tobiwan88/desk_notifier/hardware/mechanics/display_dummy.stl

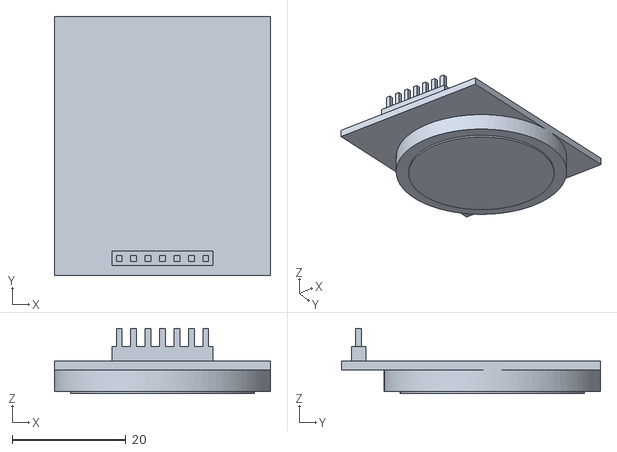
[picture p3: CAD file, 2026-10-22]
hardware/mechanics/display_dummy.stl
38.0 x 45.5 x 11.5
