tobiwan88/desk_notifier/hardware/notifier-v1/notifier-v1.step

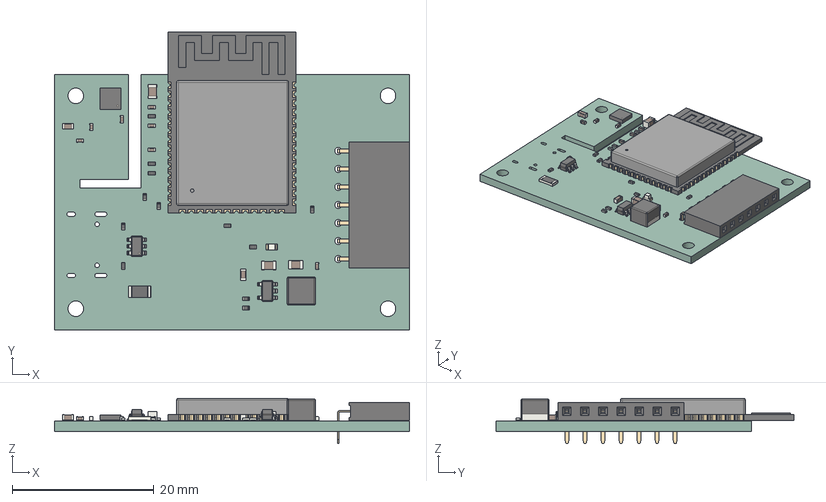
[picture p4: CAD file, 2026-10-22]
hardware/notifier-v1/notifier-v1.step
50.0 x 42.0 x 6.40 mm
Bosch_LGA_8_3x3mm_P08mm_ClockwisePinNumbering
C_0402_1005Metric x 7
R_0402_1005Metric x 12
C_0603_1608Metric x 2
C_0805_2012Metric x 3
SOT-23-6
PinSocket_1x07_P2.54mm_Horizontal
LED_0603_1608Metric
ESP32-S3-WROOM-1
SOT-23-5
L_Cenker_CKCS4030
Fuse_1206_3216Metric
notifier-v1-unsaved-export-hy6Hpy_PCB
