tobiwan88/desk_notifier/hardware/mechanics/coupon_m1.stl

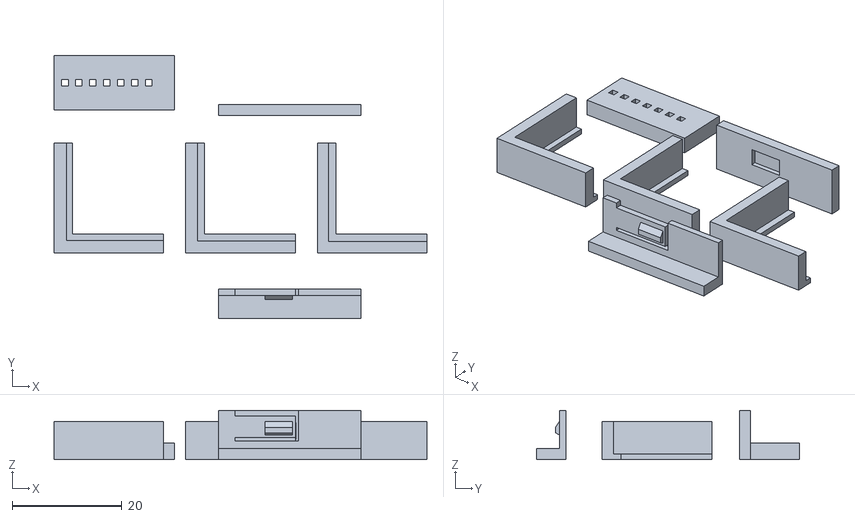
[picture p5: CAD file, 2026-10-22]
hardware/mechanics/coupon_m1.stl
68.0 x 48.0 x 9.00
