tobiwan88/desk_notifier/hardware/mechanics/plate_shell_cover.3mf

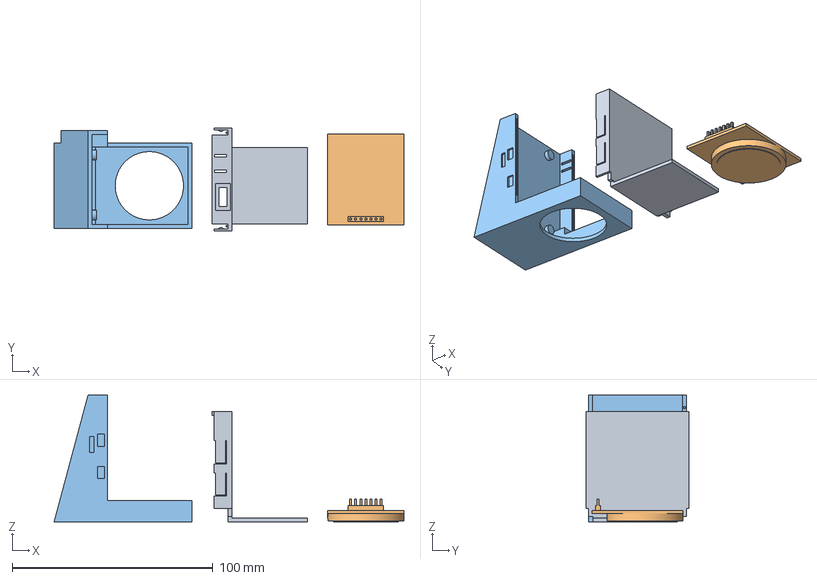
[picture p6: CAD file, 2026-10-22]
hardware/mechanics/plate_shell_cover.3mf
174.4 x 51.5 x 63.3 mm
cover
display_dummy
