tobiwan88/desk_notifier/hardware/mechanics/cover.stl

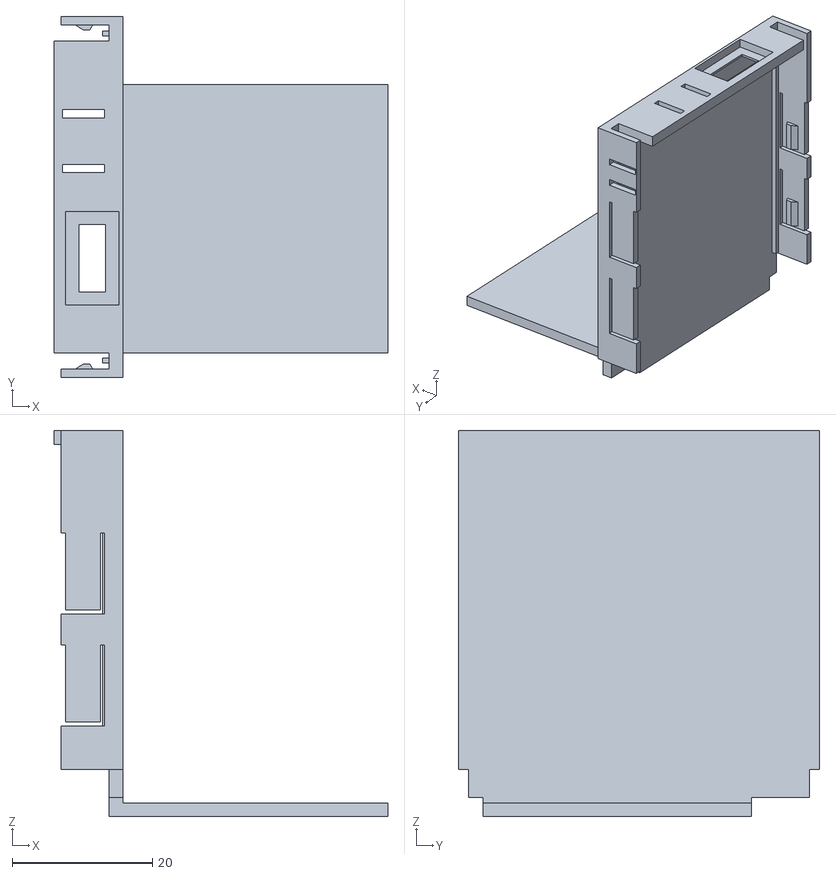
[picture p7: CAD file, 2026-10-22]
hardware/mechanics/cover.stl
47.6 x 51.5 x 55.1
