tobiwan88/desk_notifier/hardware/mechanics/shell.stl

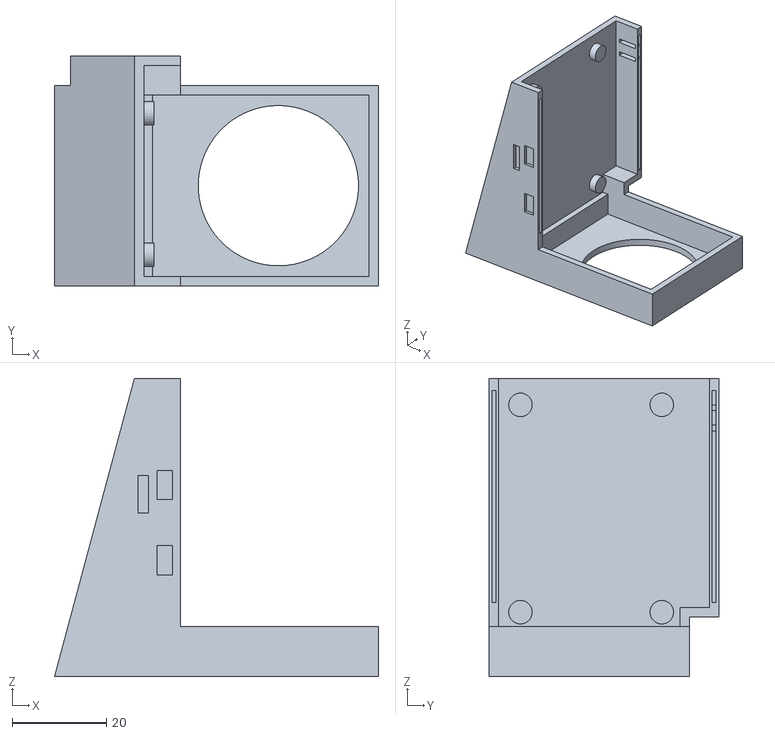
[picture p8: CAD file, 2026-10-22]
hardware/mechanics/shell.stl
68.8 x 48.7 x 63.3
