tobiwan88/desk_notifier/(list of files, cad)

Other CAD files:
hardware/mechanics/desk_notifier_housing.f3d
hardware/mechanics/plate_shell_cover.stl
