tobiwan88/desk_notifier/hardware/notifier-v1/notifier-v1.kicad_pcb

## KiCad design hardware/notifier-v1/notifier-v1.kicad_pcb (2026-10-22)

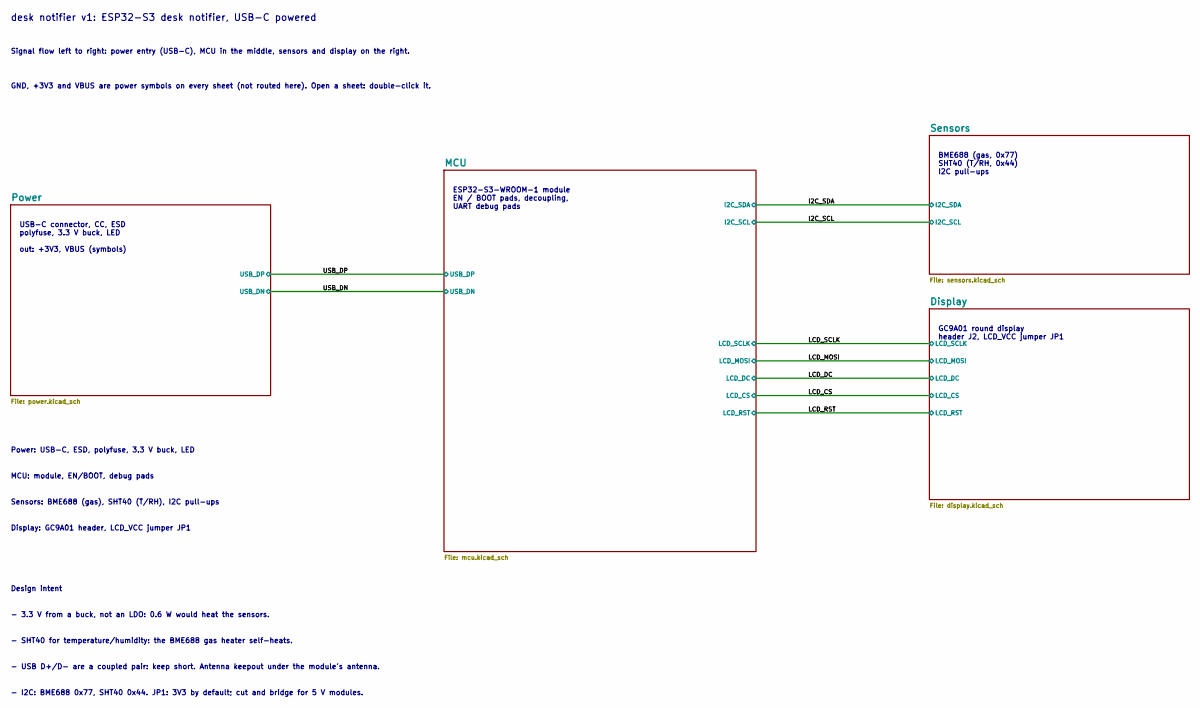
[picture p9: schematic notifier-v1.kicad_sch, desk notifier v1]

Notes on the sheet:
USB-C connector, CC, ESD polyfuse, 3.3 V buck, LED out: +3V3, VBUS (symbols)
ESP32-S3-WROOM-1 module EN / BOOT pads, decoupling, UART debug pads
Design intent
- 3.3 V from a buck, not an LDO: 0.6 W would heat the sensors.
MCU: module, EN/BOOT, debug pads
Power: USB-C, ESD, polyfuse, 3.3 V buck, LED
Signal flow left to right: power entry (USB-C), MCU in the middle, sensors and display on the right.
- USB D+/D- are a coupled pair: keep short. Antenna keepout under the module's antenna.
desk notifier v1: ESP32-S3 desk notifier, USB-C powered
GND, +3V3 and VBUS are power symbols on every sheet (not routed here). Open a sheet: double-click it.
- I2C: BME688 0x77, SHT40 0x44. JP1: 3V3 by default; cut and bridge for 5 V modules.
GC9A01 round display header J2, LCD_VCC jumper JP1
Display: GC9A01 header, LCD_VCC jumper JP1
BME688 (gas, 0x77) SHT40 (T/RH, 0x44) I2C pull-ups
Sensors: BME688 (gas), SHT40 (T/RH), I2C pull-ups
- SHT40 for temperature/humidity: the BME688 gas heater self-heats.

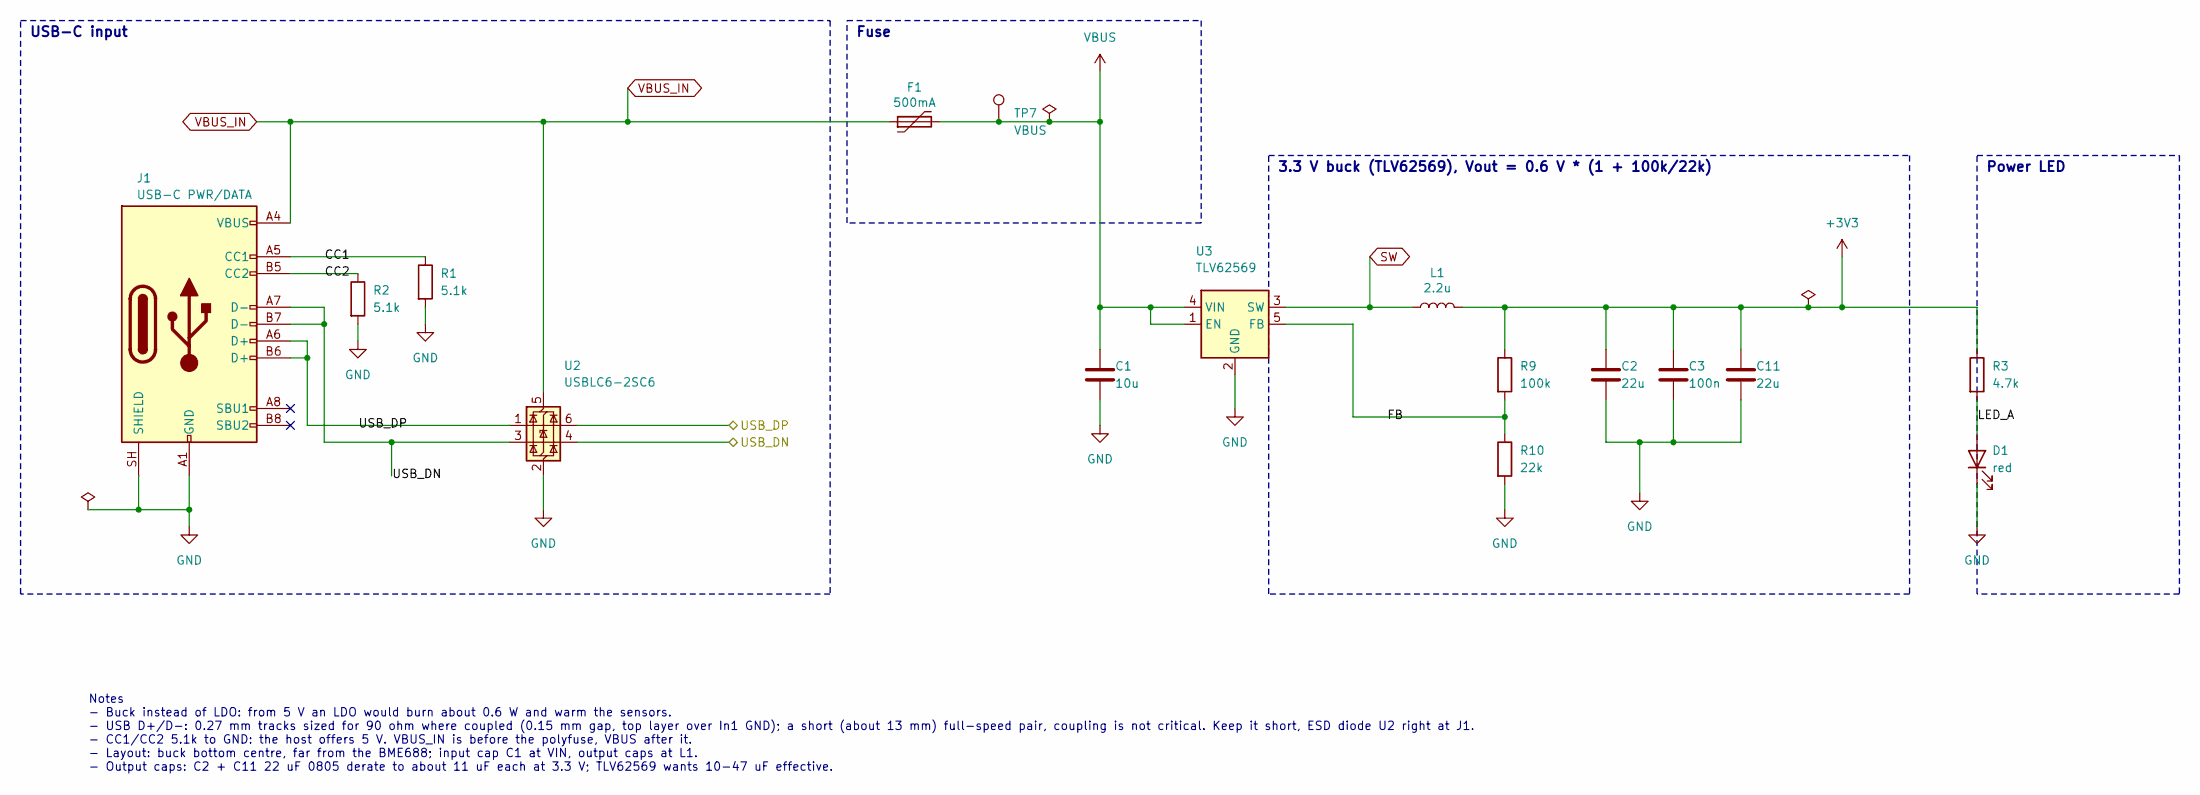
[picture p10: schematic power.kicad_sch, desk notifier v1]

Parts:
C1: 10u; C_0603_1608Metric; LCSC C19702
C2, C11: 22u; C_0805_2012Metric; LCSC C45783
C3: 100n; C_0402_1005Metric; LCSC C1525
D1: red; LED_0603_1608Metric; LCSC C2286
F1: 500mA; Fuse_1206_3216Metric; LCSC C70077
J1: USB-C PWR/DATA; USB_C_Receptacle_HRO_TYPE-C-31-M-12; LCSC C165948
L1: 2.2u; L_Cenker_CKCS4030; LCSC C354584
R1, R2: 5.1k; R_0402_1005Metric; LCSC C25905
R3: 4.7k; R_0402_1005Metric; LCSC C25900
R9: 100k; R_0402_1005Metric; LCSC C25741
R10: 22k; R_0402_1005Metric; LCSC C25768
TP7: VBUS; TestPoint_Pad_D1.0mm
U2: USBLC6-2SC6; SOT-23-6; LCSC C7519
U3: TLV62569; SOT-23-5; LCSC C141836

Connections:
+3V3: C2.1, C3.1, C11.1, L1.2, R3.1, R9.1; also elsewhere on the board
/Power/CC1: J1.A5 (CC1), R1.1
/Power/CC2: J1.B5 (CC2), R2.1
/Power/FB: R9.2, R10.1, U3.5 (FB)
/Power/LED_A: D1.2 (A), R3.2
/USB_DN: J1.A7 (D-), J1.B7 (D-), U2.3 (I/O2), U2.4 (I/O2); also elsewhere on the board
/USB_DP: J1.A6 (D+), J1.B6 (D+), U2.1 (I/O1), U2.6 (I/O1); also elsewhere on the board
GND: C1.2, C2.2, C3.2, C11.2, D1.1 (K), J1.A1 (GND), J1.A12 (GND), J1.B1 (GND), J1.B12 (GND), J1.SH (SHIELD), R1.2, R2.2, R10.2, U2.2 (GND), U3.2 (GND); also elsewhere on the board
SW: L1.1, U3.3 (SW)
VBUS: C1.1, F1.2, TP7.1, U3.1 (EN), U3.4 (VIN); also elsewhere on the board
VBUS_IN: F1.1, J1.A4 (VBUS), J1.A9 (VBUS), J1.B4 (VBUS), J1.B9 (VBUS), U2.5 (VBUS)

Notes on the sheet:
3.3 V buck (TLV62569), Vout = 0.6 V * (1 + 100k/22k)
USB-C input
Notes - Buck instead of LDO: from 5 V an LDO would burn about 0.6 W and warm the sensors. - USB D+/D-: 0.27 mm tracks sized for 90 ohm where coupled (0.15 mm gap, top layer over In1 GND); a short (about 13 mm) full-speed pair, coupling is not critical. Keep it short, ESD diode U2 right at J1. - CC1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
Power LED
Fuse

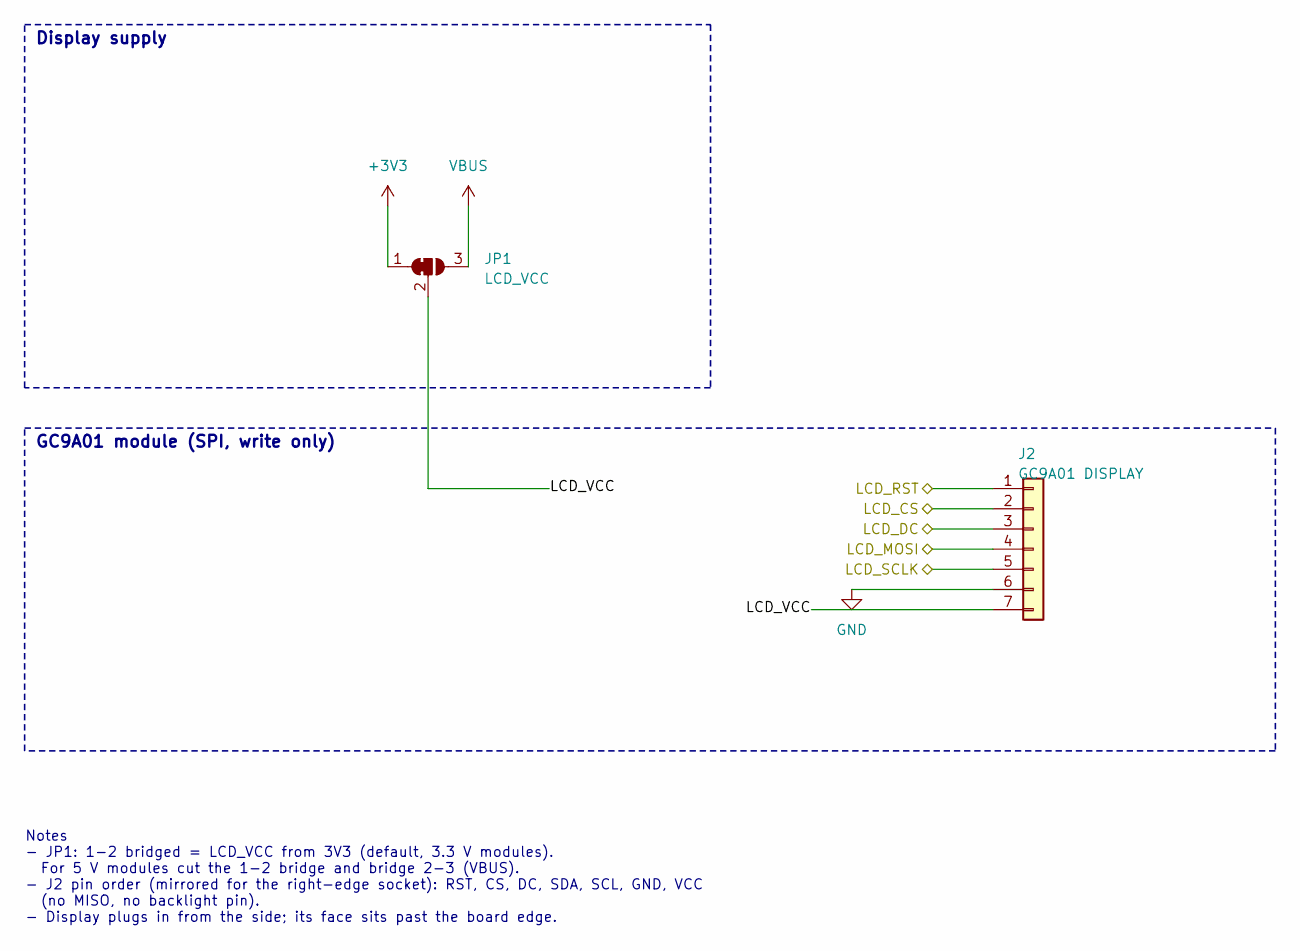
[picture p11: schematic display.kicad_sch, desk notifier v1]

Parts:
J2: GC9A01 DISPLAY; PinSocket_1x07_P2.54mm_Horizontal; LCSC C22436148
JP1: LCD_VCC; SolderJumper-3_P1.3mm_Bridged12_RoundedPad1.0x1.5mm

Connections:
+3V3: JP1.1 (A); also elsewhere on the board
/Display/LCD_VCC: J2.7, JP1.2 (C)
/LCD_CS: J2.2; also elsewhere on the board
/LCD_DC: J2.3; also elsewhere on the board
/LCD_MOSI: J2.4; also elsewhere on the board
/LCD_RST: J2.1; also elsewhere on the board
/LCD_SCLK: J2.5; also elsewhere on the board
GND: J2.6; also elsewhere on the board
VBUS: JP1.3 (B); also elsewhere on the board

Notes on the sheet:
Display supply
GC9A01 module (SPI, write only)
Notes - JP1: 1-2 bridged = LCD_VCC from 3V3 (default, 3.3 V modules). For 5 V modules cut the 1-2 bridge and bridge 2-3 (VBUS). - J2 pin order (mirrored for the right-edge socket): RST, CS, DC, SDA, SCL, GND, VCC (no MISO, no backlight pin). - Display plugs in from the side; its face sits past the 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

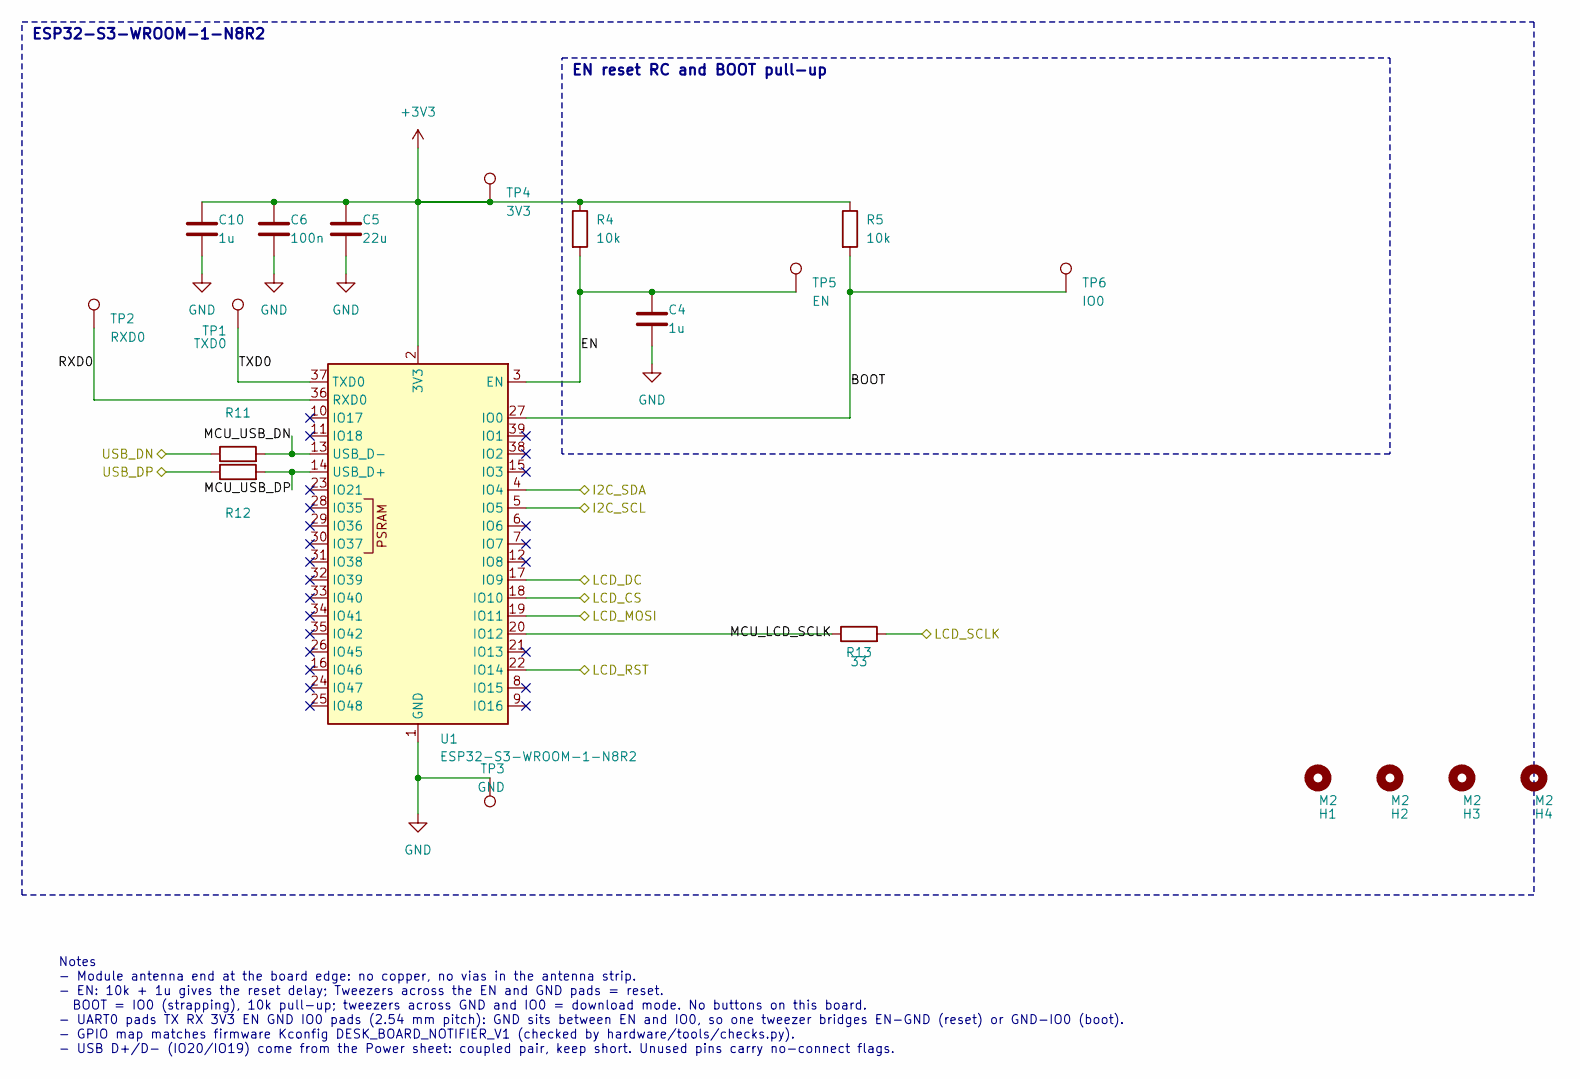
[picture p12: schematic mcu.kicad_sch, desk notifier v1]

Parts:
C4, C10: 1u; C_0402_1005Metric; LCSC C52923
C5: 22u; C_0805_2012Metric; LCSC C45783
C6: 100n; C_0402_1005Metric; LCSC C1525
H1, H2, H3, H4: M2; MountingHole_2.2mm_M2
R4, R5: 10k; R_0402_1005Metric; LCSC C25744
R11, R12: 22; R_0402_1005Metric; LCSC C25092
R13: 33; R_0402_1005Metric; LCSC C25105
TP1: TXD0; TestPoint_Pad_D1.5mm
TP2: RXD0; TestPoint_Pad_D1.5mm
TP3: GND; TestPoint_Pad_D1.5mm
TP4: 3V3; TestPoint_Pad_D1.5mm
TP5: EN; TestPoint_Pad_D1.5mm
TP6: IO0; TestPoint_Pad_D1.5mm
U1: ESP32-S3-WROOM-1-N8R2; ESP32-S3-WROOM-1; LCSC C2913204

Connections:
+3V3: C5.1, C6.1, C10.1, R4.1, R5.1, TP4.1, U1.2 (3V3); also elsewhere on the board
/I2C_SCL: U1.5 (IO5); also elsewhere on the board
/I2C_SDA: U1.4 (IO4); also elsewhere on the board
/LCD_CS: U1.18 (IO10); also elsewhere on the board
/LCD_DC: U1.17 (IO9); also elsewhere on the board
/LCD_MOSI: U1.19 (IO11); also elsewhere on the board
/LCD_RST: U1.22 (IO14); also elsewhere on the board
/LCD_SCLK: R13.2; also elsewhere on the board
/MCU/BOOT: R5.2, TP6.1, U1.27 (IO0)
/MCU/EN: C4.1, R4.2, TP5.1, U1.3 (EN)
/MCU/MCU_LCD_SCLK: R13.1, U1.20 (IO12)
/MCU/MCU_USB_DN: R11.2, U1.13 (USB_D-)
/MCU/MCU_USB_DP: R12.2, U1.14 (USB_D+)
/MCU/RXD0: TP2.1, U1.36 (RXD0)
/MCU/TXD0: TP1.1, U1.37 (TXD0)
/USB_DN: R11.1; also elsewhere on the board
/USB_DP: R12.1; also elsewhere on the board
GND: C4.2, C5.2, C6.2, C10.2, TP3.1, U1.1 (GND), U1.40 (GND), U1.41 (GND); also elsewhere on the board

Notes on the sheet:
ESP32-S3-WROOM-1-N8R2
EN reset RC and BOOT pull-up
Notes - Module antenna end at the board edge: no copper, no vias in the antenna strip. - EN: 10k + 1u gives the reset delay; Tweezers across the EN and GND pads = reset. BOOT = IO0 (strapping), 10k pull-up; tweezers across GND and IO0 = download mode. No buttons on this board. - UART0 pads TX RX 3V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

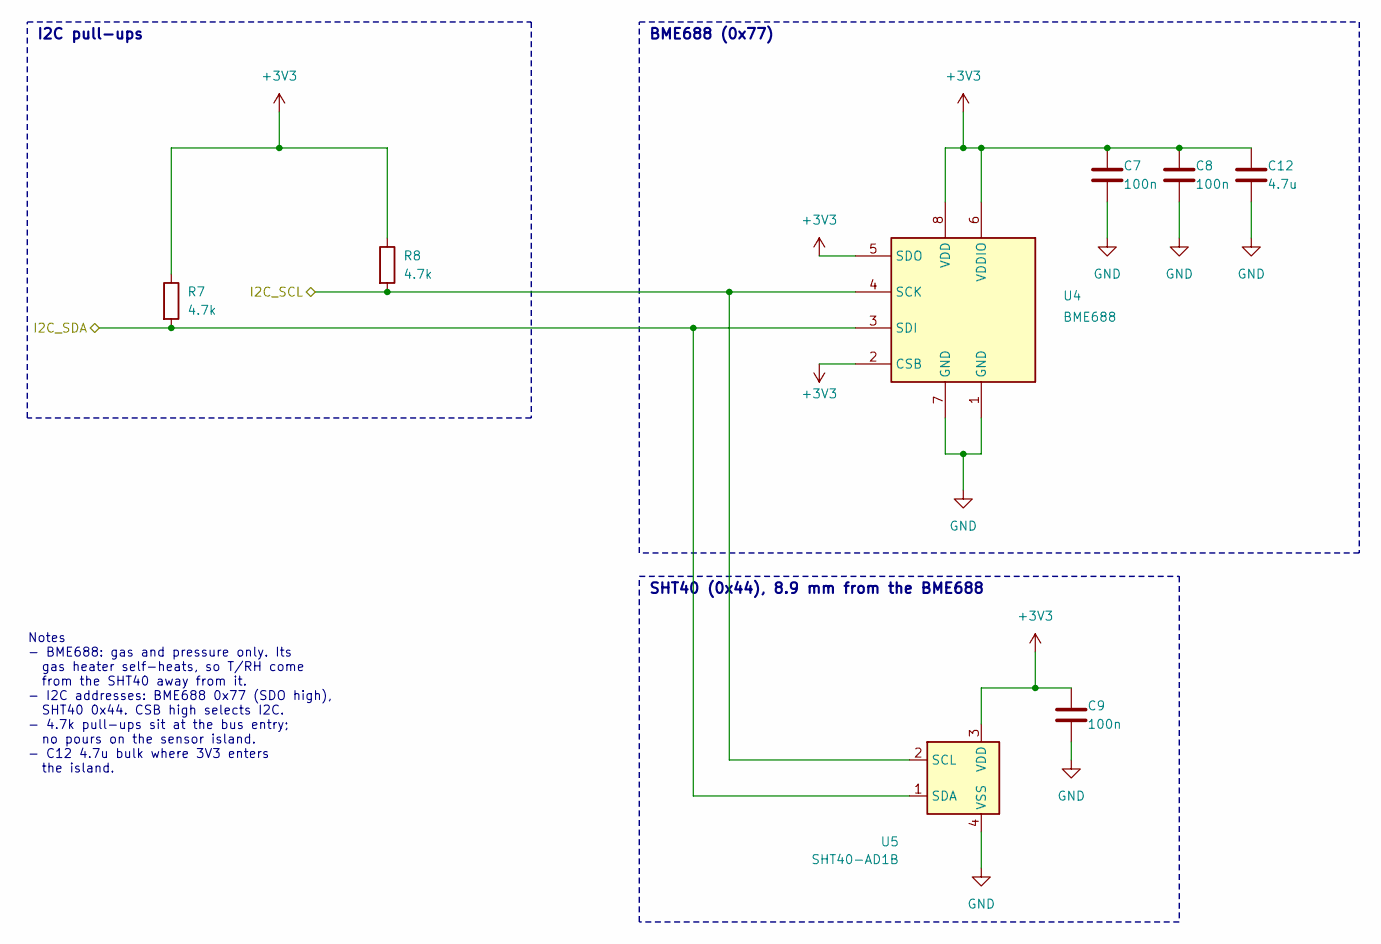
[picture p13: schematic sensors.kicad_sch, desk notifier v1]

Parts:
C7, C8, C9: 100n; C_0402_1005Metric; LCSC C1525
C12: 4.7u; C_0603_1608Metric; LCSC C19666
R7, R8: 4.7k; R_0402_1005Metric; LCSC C25900
U4: BME688; Bosch_LGA-8_3x3mm_P0.8mm_ClockwisePinNumbering; LCSC C3664478
U5: SHT40-AD1B; Sensirion_DFN-4_1.5x1.5mm_P0.8mm_SHT4x_NoCentralPad; LCSC C2909890

Connections:
+3V3: C7.1, C8.1, C9.1, C12.1, R7.1, R8.1, U4.2 (CSB), U4.5 (SDO), U4.6 (VDDIO), U4.8 (VDD), U5.3 (VDD); also elsewhere on the board
/I2C_SCL: R8.2, U4.4 (SCK), U5.2 (SCL); also elsewhere on the board
/I2C_SDA: R7.2, U4.3 (SDI), U5.1 (SDA); also elsewhere on the board
GND: C7.2, C8.2, C9.2, C12.2, U4.1 (GND), U4.7 (GND), U5.4 (VSS); also elsewhere on the board

Notes on the sheet:
SHT40 (0x44), 8.9 mm from the BME688
Notes - BME688: gas and pressure only. Its gas heater self-heats, so T/RH come from the SHT40 away from it. - I2C addresses: BME688 0x77 (SDO high), SHT40 0x44. CSB high selects I2C. - 4.7k pull-ups sit at the bus entry; no pours on the sensor island. - C12 4.7u bulk where 3V3 enters the island.
BME688 (0x77)
I2C pull-ups

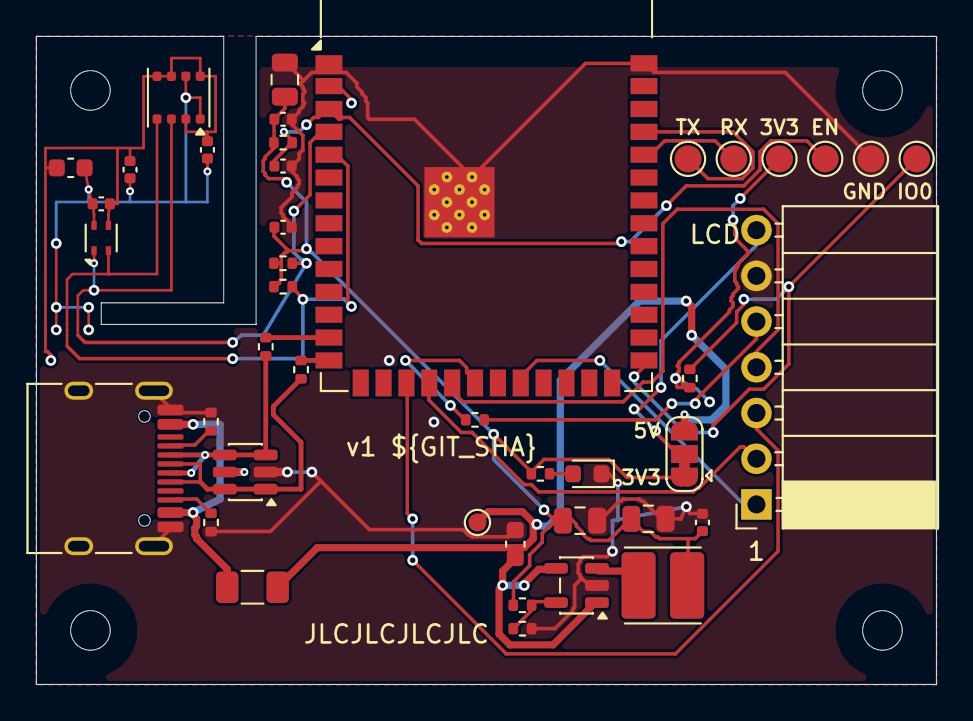
[picture p14: board notifier-v1.kicad_pcb from above]

Board: 4 copper layers, 50.0 x 36.0 mm, 46 parts (0 on the bottom side), 26 nets.
