tobiwan88/desk_notifier/hardware/gen/notifier_v1.py

"""notifier-v1 schematic: ESP32-S3-WROOM-1, USB-C power/data, TLV62569 buck, BME688, 7-pin GC9A01 header, SHT40.

PARTS and NETS are the source of truth; the checks (tools/checks.py) import them.
Run: uv run --package desk-hardware python hardware/gen/notifier_v1.py [out_dir]
"""

import sys
from pathlib import Path

sys.path.insert(0, str(Path(__file__).resolve().parent))
from schkit import check_nets  # noqa: E402

R0402, C0402 = "Resistor_SMD:R_0402_1005Metric", "Capacitor_SMD:C_0402_1005Metric"
C0603, C0805 = "Capacitor_SMD:C_0603_1608Metric", "Capacitor_SMD:C_0805_2012Metric"

# ref: (symbol, value, footprint, LCSC, schematic sheet, rotation on the PCB-era sketch (unused by the drawing))
PARTS = {
    # USB-C input and ESD
    "J1": ("Connector:USB_C_Receptacle_USB2.0_16P", "USB-C PWR/DATA", "Connector_USB:USB_C_Receptacle_HRO_TYPE-C-31-M-12", "C165948", "Power", 0),
    "R1": ("Device:R", "5.1k", R0402, "C25905", "Power", 0),
    "R2": ("Device:R", "5.1k", R0402, "C25905", "Power", 0),
    "U2": ("Power_Protection:USBLC6-2SC6", "USBLC6-2SC6", "Package_TO_SOT_SMD:SOT-23-6", "C7519", "Power", 0),
    # VBUS polyfuse, 3.3 V buck (a linear regulator would burn ~0.6 W and warm the BME688)
    "F1": ("Device:Polyfuse", "500mA", "Fuse:Fuse_1206_3216Metric", "C70077", "Power", 90),
    "U3": ("Regulator_Switching:TLV62569DBV", "TLV62569", "Package_TO_SOT_SMD:SOT-23-5", "C141836", "Power", 0),
    "L1": ("Device:L", "2.2u", "Inductor_SMD:L_Cenker_CKCS4030", "C354584", "Power", 90),
    "R9": ("Device:R", "100k", R0402, "C25741", "Power", 0),   # Vout = 0.6 V * (1 + R9/R10) = 3.33 V
    "R10": ("Device:R", "22k", R0402, "C25768", "Power", 0),
    "C1": ("Device:C", "10u", C0603, "C19702", "Power", 0),
    # Output cap: TI TLV62569 datasheet (https://www.ti.com/lit/ds/symlink/tlv62569.pdf) sec 8.2.2.5: 10-47 uF effective.
    # One 22 uF 0805 derates to about 11 uF at 3.3 V DC bias, so C11 is a second one for margin.
    "C2": ("Device:C", "22u", C0805, "C45783", "Power", 0),
    "C11": ("Device:C", "22u", C0805, "C45783", "Power", 0),
    "C3": ("Device:C", "100n", C0402, "C1525", "Power", 0),
    "R3": ("Device:R", "4.7k", R0402, "C25900", "Power", 0),
    "D1": ("Device:LED", "red", "LED_SMD:LED_0603_1608Metric", "C2286", "Power", 90),
    # ESP32-S3 module, reset RC, boot pull-up (no buttons on this board: debug pads)
    "U1": ("RF_Module:ESP32-S3-WROOM-1", "ESP32-S3-WROOM-1-N8R2", "RF_Module:ESP32-S3-WROOM-1", "C2913204", "MCU", 0),
    # 3V3 decoupling per Espressif ESP32-S3 Hardware Design Guidelines, schematic checklist "Power Supply"
    # (https://docs.espressif.com/projects/esp-hardware-design-guidelines/en/latest/esp32s3/schematic-checklist.html):
    # 10 uF + 1 uF + 0.1 uF at the module 3V3 pin. C5 22 uF 0805 (>=10 uF after derating), C10 1 uF, C6 100 nF.
    "C5": ("Device:C", "22u", C0805, "C45783", "MCU", 0),
    "C6": ("Device:C", "100n", C0402, "C1525", "MCU", 0),
    "C10": ("Device:C", "1u", C0402, "C52923", "MCU", 0),
    # USB D+/D- series resistors, 22 ohm, close to the module pins: Espressif schematic checklist, section "USB"
    # (same URL): "series resistors of 22 to 33 ohm" on D+/D-. UNI-ROYAL 0402WGF220JTCE, 1 %, Basic.
    "R11": ("Device:R", "22", R0402, "C25092", "MCU", 0),   # USB_DN -> MCU_USB_DN (module pin 13)
    "R12": ("Device:R", "22", R0402, "C25092", "MCU", 0),   # USB_DP -> MCU_USB_DP (module pin 14)
    "R13": ("Device:R", "33", R0402, "C25105", "MCU", 0),   # LCD SCLK series termination at module pin 20
    "R4": ("Device:R", "10k", R0402, "C25744", "MCU", 0),
    "C4": ("Device:C", "1u", C0402, "C52923", "MCU", 0),
    "R5": ("Device:R", "10k", R0402, "C25744", "MCU", 0),
    # BME688 (BME680 symbol: same LGA-8 pinout)
    "U4": ("Sensor:BME680", "BME688", "Package_LGA:Bosch_LGA-8_3x3mm_P0.8mm_ClockwisePinNumbering", "C3664478", "Sensors", 0),
    "C7": ("Device:C", "100n", C0402, "C1525", "Sensors", 0),
    "C8": ("Device:C", "100n", C0402, "C1525", "Sensors", 0),
    # SHT40 (0x44): temperature/humidity away from the BME688's gas heater
    "U5": ("Sensor_Humidity:SHT4x", "SHT40-AD1B", "Sensor_Humidity:Sensirion_DFN-4_1.5x1.5mm_P0.8mm_SHT4x_NoCentralPad", "C2909890", "Sensors", 0),
    "C9": ("Device:C", "100n", C0402, "C1525", "Sensors", 0),
    "C12": ("Device:C", "4.7u", C0603, "C19666", "Sensors", 0),   # bulk where 3V3 enters the island (gas heater pulses)
    "R7": ("Device:R", "4.7k", R0402, "C25900", "Sensors", 0),
    "R8": ("Device:R", "4.7k", R0402, "C25900", "Sensors", 0),
    # GC9A01 display header and its supply selector (default 3V3, cut and bridge 2-3 for 5 V)
    "J2": ("Connector_Generic:Conn_01x07", "GC9A01 DISPLAY", "Connector_PinSocket_2.54mm:PinSocket_1x07_P2.54mm_Horizontal", "C22436148", "Display", 0),
    "JP1": ("Jumper:SolderJumper_3_Bridged12", "LCD_VCC", "Jumper:SolderJumper-3_P1.3mm_Bridged12_RoundedPad1.0x1.5mm", None, "Display", 0),
    # debug UART pads, mounting holes
    "TP1": ("Connector:TestPoint", "TXD0", "TestPoint:TestPoint_Pad_D1.5mm", None, "MCU", 0),
    "TP2": ("Connector:TestPoint", "RXD0", "TestPoint:TestPoint_Pad_D1.5mm", None, "MCU", 0),
    "TP3": ("Connector:TestPoint", "GND", "TestPoint:TestPoint_Pad_D1.5mm", None, "MCU", 0),
    "TP4": ("Connector:TestPoint", "3V3", "TestPoint:TestPoint_Pad_D1.5mm", None, "MCU", 0),
    "TP5": ("Connector:TestPoint", "EN", "TestPoint:TestPoint_Pad_D1.5mm", None, "MCU", 0),
    "TP6": ("Connector:TestPoint", "IO0", "TestPoint:TestPoint_Pad_D1.5mm", None, "MCU", 0),
    "TP7": ("Connector:TestPoint", "VBUS", "TestPoint:TestPoint_Pad_D1.0mm", None, "Power", 0),
    "H1": ("Mechanical:MountingHole", "M2", "MountingHole:MountingHole_2.2mm_M2", None, "MCU", 0),
    "H2": ("Mechanical:MountingHole", "M2", "MountingHole:MountingHole_2.2mm_M2", None, "MCU", 0),
    "H3": ("Mechanical:MountingHole", "M2", "MountingHole:MountingHole_2.2mm_M2", None, "MCU", 0),
    "H4": ("Mechanical:MountingHole", "M2", "MountingHole:MountingHole_2.2mm_M2", None, "MCU", 0),
    "#FLG01": ("power:PWR_FLAG", "PWR_FLAG", None, None, "Power", 0),
    "#FLG02": ("power:PWR_FLAG", "PWR_FLAG", None, None, "Power", 0),
    "#FLG03": ("power:PWR_FLAG", "PWR_FLAG", None, None, "Power", 0),
}

# module pin -> GPIO, for the pin map check against firmware Kconfig
U1_GPIO = {"4": 4, "5": 5, "17": 9, "18": 10, "19": 11, "20": 12, "22": 14, "27": 0, "13": 19, "14": 20, "37": 43, "36": 44}
U1_UNUSED = ["6", "7", "8", "9", "10", "11", "12", "15", "16", "21", "23", "24", "25", "26", "28", "29", "30", "31", "32", "33", "34", "35", "38", "39"]

NETS = {
    "VBUS_IN": [("J1", "A4"), ("J1", "A9"), ("J1", "B4"), ("J1", "B9"), ("U2", "5"), ("F1", "1")],
    "VBUS": [("F1", "2"), ("U3", "4"), ("U3", "1"), ("C1", "1"), ("JP1", "3"), ("TP7", "1"), ("#FLG01", "1")],
    "SW": [("U3", "3"), ("L1", "1")],
    "FB": [("U3", "5"), ("R9", "2"), ("R10", "1")],
    "GND": [("J1", "A1"), ("J1", "A12"), ("J1", "B1"), ("J1", "B12"), ("J1", "SH"), ("R1", "2"), ("R2", "2"), ("U2", "2"),
            ("U3", "2"), ("R10", "2"), ("C1", "2"), ("C2", "2"), ("C3", "2"), ("C11", "2"), ("D1", "1"), ("U1", "1"), ("U1", "40"), ("U1", "41"),
            ("C5", "2"), ("C6", "2"), ("C10", "2"), ("C4", "2"), ("U4", "1"), ("U4", "7"),
            ("C7", "2"), ("C8", "2"), ("U5", "4"), ("C9", "2"), ("C12", "2"), ("J2", "6"), ("TP3", "1"), ("#FLG02", "1")],
    "+3V3": [("L1", "2"), ("R9", "1"), ("TP4", "1"), ("#FLG03", "1"), ("C2", "1"), ("C3", "1"), ("C11", "1"), ("C10", "1"), ("R3", "1"), ("U1", "2"), ("C5", "1"), ("C6", "1"), ("R4", "1"),
             ("R5", "1"), ("U4", "8"), ("U4", "6"), ("U4", "2"), ("U4", "5"), ("C7", "1"), ("C8", "1"), ("U5", "3"), ("C9", "1"), ("C12", "1"),
             ("R7", "1"), ("R8", "1"), ("JP1", "1")],
    "CC1": [("J1", "A5"), ("R1", "1")],
    "CC2": [("J1", "B5"), ("R2", "1")],
    "USB_DP": [("J1", "A6"), ("J1", "B6"), ("U2", "1"), ("U2", "6"), ("R12", "1")],
    "MCU_USB_DP": [("R12", "2"), ("U1", "14")],
    "USB_DN": [("J1", "A7"), ("J1", "B7"), ("U2", "3"), ("U2", "4"), ("R11", "1")],
    "MCU_USB_DN": [("R11", "2"), ("U1", "13")],
    "LED_A": [("R3", "2"), ("D1", "2")],
    "EN": [("U1", "3"), ("R4", "2"), ("C4", "1"), ("TP5", "1")],
    "BOOT": [("U1", "27"), ("R5", "2"), ("TP6", "1")],
    "I2C_SDA": [("U1", "4"), ("U4", "3"), ("U5", "1"), ("R7", "2")],
    "I2C_SCL": [("U1", "5"), ("U4", "4"), ("U5", "2"), ("R8", "2")],
    "LCD_VCC": [("JP1", "2"), ("J2", "7")],
    "MCU_LCD_SCLK": [("U1", "20"), ("R13", "1")],
    "LCD_SCLK": [("R13", "2"), ("J2", "5")],
    "LCD_MOSI": [("U1", "19"), ("J2", "4")],
    "LCD_DC": [("U1", "17"), ("J2", "3")],
    "LCD_CS": [("U1", "18"), ("J2", "2")],
    "LCD_RST": [("U1", "22"), ("J2", "1")],
    "TXD0": [("U1", "37"), ("TP1", "1")],
    "RXD0": [("U1", "36"), ("TP2", "1")],
}
NO_CONNECT = {"J1": ["A8", "B8"], "U1": U1_UNUSED}




def build(out: Path) -> Path:
    """Write the hierarchical schematic (root + sheets, drawn in sheets_v1.py) into out/."""
    import sheets_v1
    out.mkdir(parents=True, exist_ok=True)
    return sheets_v1.build(out, PARTS, NO_CONNECT)


if __name__ == "__main__":
    path = build(Path(sys.argv[1] if len(sys.argv) > 1 else "hardware/notifier-v1"))
    errors = check_nets(path, NETS)
    print("\n".join(errors) or f"{path}: nets OK")
    sys.exit(1 if errors else 0)
