tobiwan88/desk_notifier/firmware/components/net/idf/console.cpp

// UART/USB console (plan §5.6).
#include <fcntl.h>
#include <unistd.h>

#include <cstdio>
#include <cstdlib>
#include <cstring>
#include <string>

#include "clock/idf/clock.hpp"
#include "display/idf/display.hpp"
#include "screen/idf/screen_task.hpp"
#include "sensor/idf/bme688.hpp"
#include "driver/gpio.h"
#include "esp_console.h"
#include "freertos/FreeRTOS.h"
#include "freertos/task.h"
#include "sdkconfig.h"
#include "esp_heap_caps.h"
#include "esp_timer.h"
#include "esp_log.h"
#include "esp_system.h"
#include "net/idf/net.hpp"
#include "settings/idf/settings.hpp"
#include "weather/idf/client.hpp"

namespace net {
namespace {

int cmd_wifi(int argc, char** argv) {
    if (argc == 2 && !std::strcmp(argv[1], "show")) {
        std::printf("ssid=%s connected=%d ip=%s rssi=%d\n", settings::get("ssid").value_or("(kconfig)").c_str(),
                    connected(), ip().c_str(), rssi());
        return 0;
    }
    if (argc < 2) { std::printf("usage: wifi <ssid> [password] | wifi show\n"); return 1; }
    settings::set("ssid", argv[1]);
    settings::set("pass", argc > 2 ? argv[2] : "");
    std::printf("saved; rebooting\n");
    esp_restart();
    return 0;
}
int cmd_token(int argc, char** argv) {
    if (argc == 2 && !std::strcmp(argv[1], "show")) { std::printf("%s\n", token().c_str()); return 0; }
    if (argc == 3 && !std::strcmp(argv[1], "set")) { settings::set("token", argv[2]); std::printf("ok\n"); return 0; }
    if (argc == 2 && !std::strcmp(argv[1], "new")) { settings::set("token", ""); std::printf("%s\n", token().c_str()); return 0; }
    std::printf("usage: token show | set <t> | new\n");
    return 1;
}
int cmd_auth(int argc, char** argv) {
    if (argc == 2 && !std::strcmp(argv[1], "open")) { settings::set("open", "1"); std::printf("anonymous access ON (reboot to apply)\n"); return 0; }
    if (argc == 2 && !std::strcmp(argv[1], "token")) { settings::set("open", "0"); std::printf("token required (reboot to apply)\n"); return 0; }
    std::printf("auth: %s | usage: auth open|token\n", open_access() ? "open" : "token");
    return 0;
}
int cmd_hostname(int argc, char** argv) {
    if (argc != 2) { std::printf("%s\n", hostname().c_str()); return 0; }
    settings::set("hostname", argv[1]);
    std::printf("saved; reboot to apply\n");
    return 0;
}
int cmd_status(int, char**) {
    std::printf("resets: %s\n", settings::get("rst").value_or("").c_str());
    const auto st = screen::stats();
    std::printf("host=%s ip=%s rssi=%d frame_avg=%luus time=%d heap=%lu\n", hostname().c_str(), ip().c_str(), rssi(),
                static_cast<unsigned long>(st.frame_us_avg), clock_sync::valid(), static_cast<unsigned long>(esp_get_free_heap_size()));
    return 0;
}
int cmd_fsbench(int argc, char** argv) {
    if (argc < 2) { std::printf("usage: fsbench <clip>\n"); return 1; }
    char path[96];
    std::snprintf(path, sizeof path, "/fs/clips/%s.clip", argv[1]);
    for (std::size_t chunk : {4096u, 16384u, 32768u}) {
        int fd = open(path, O_RDONLY);
        if (fd < 0) { std::printf("cannot open\n"); return 1; }
        auto* buf = static_cast<char*>(heap_caps_malloc(chunk, MALLOC_CAP_DMA | MALLOC_CAP_INTERNAL));
        if (!buf) { close(fd); std::printf("no memory for %u\n", static_cast<unsigned>(chunk)); continue; }
        const int64_t t0 = esp_timer_get_time();
        std::size_t total = 0;
        for (ssize_t n; (n = read(fd, buf, chunk)) > 0;) total += static_cast<std::size_t>(n);
        const int64_t us = esp_timer_get_time() - t0;
        std::printf("chunk=%u: %u bytes in %lld ms = %u KB/s\n", static_cast<unsigned>(chunk), static_cast<unsigned>(total),
                    static_cast<long long>(us / 1000), static_cast<unsigned>(total * 1000000ULL / (us ? us : 1) / 1024));
        heap_caps_free(buf);
        close(fd);
    }
    return 0;
}
int cmd_lcd(int argc, char** argv) {  // display diagnostics
    if (argc >= 2 && !std::strcmp(argv[1], "init")) {
        const auto r = display::reinit(argc > 2 ? std::atoi(argv[2]) : 0);
        std::printf(r ? "ok, spi=%d Hz\n" : "failed\n", display::spi_hz());
        return r ? 0 : 1;
    }
    if (argc >= 2 && !std::strcmp(argv[1], "pins")) {  // idle levels: CS must read 1 between transfers
        const int pins[] = {CONFIG_DESK_LCD_PIN_CS, CONFIG_DESK_LCD_PIN_DC, CONFIG_DESK_LCD_PIN_RST};
        const char* names[] = {"CS", "DC", "RST"};
        for (int i = 0; i < 3; ++i) std::printf("%s(gpio%d)=%d ", names[i], pins[i], gpio_get_level(static_cast<gpio_num_t>(pins[i])));
        std::printf("\n");
        return 0;
    }
    std::printf("usage: lcd pins | lcd init [spi_hz]\n");
    return 1;
}
int cmd_sensor(int, char**) {
    const auto s = sensor::latest();
    std::printf("ok=%d temp=%.2fC rh=%.1f%% p=%.1fhPa gas=%.0fohm valid=%d score=%d level=%s errors=%d\n", s.ok,
                static_cast<double>(s.reading.temp_c), static_cast<double>(s.reading.rh), static_cast<double>(s.reading.hpa),
                static_cast<double>(s.reading.gas_ohm), s.reading.gas_valid, s.quality.score, sensor::level_name(s.quality.level), s.errors);
    return 0;
}
int cmd_ack(int, char**) { screen::ack(); return 0; }
int cmd_bench(int, char**) {
    screen::bench();
    std::printf("benchmark queued: the result appears in the log within a second\n");
    return 0;
}
int cmd_page(int argc, char** argv) {  // page clock|air|day|next
    if (argc == 2 && !std::strcmp(argv[1], "next")) { screen::next_page(); return 0; }
    if (argc == 2) if (const auto p = screen::page_from_name(argv[1])) { screen::show_page(*p); return 0; }
    std::printf("now: %s\nusage: page clock|air|day|next\n", screen::page_name(screen::page()));
    return 1;
}
int cmd_weather(int argc, char** argv) {  // weather | weather refresh | weather at <lat> <lon> [name]
    if (argc >= 4 && !std::strcmp(argv[1], "at")) {
        settings::set("wx_lat", argv[2]);
        settings::set("wx_lon", argv[3]);
        if (argc >= 5) settings::set("wx_place", argv[4]);
        std::printf("saved (place name shows after a reboot)\n");
        weather::refresh();
        return 0;
    }
    if (argc == 2 && !std::strcmp(argv[1], "refresh")) { weather::refresh(); return 0; }
    const auto w = weather::latest();
    std::printf("%s ok=%d %.1f C code=%d %s hi=%.1f lo=%.1f rain=%d%% age=%lus errors=%d http=%d\n", weather::place().c_str(), w.ok,
                static_cast<double>(w.forecast.temp_c), w.forecast.code, weather::sky_name(w.forecast.sky, w.forecast.is_day),
                static_cast<double>(w.forecast.max_c), static_cast<double>(w.forecast.min_c), w.forecast.precip_pct,
                static_cast<unsigned long>(w.age_s), w.errors, w.http_status);
    return 0;
}
int cmd_reboot(int, char**) { esp_restart(); return 0; }
int cmd_factory(int, char**) { settings::erase_all(); std::printf("NVS erased (clips kept); rebooting\n"); esp_restart(); return 0; }

}  // namespace

std::expected<void, engine::Err> start_console() noexcept {
    esp_console_repl_t* repl = nullptr;
    esp_console_repl_config_t rc = ESP_CONSOLE_REPL_CONFIG_DEFAULT();
    rc.prompt = "desk> ";
    rc.task_stack_size = 4096;
    rc.task_priority = 2;
    esp_console_dev_usb_serial_jtag_config_t dc = ESP_CONSOLE_DEV_USB_SERIAL_JTAG_CONFIG_DEFAULT();
    if (esp_console_new_repl_usb_serial_jtag(&dc, &rc, &repl) != ESP_OK) return std::unexpected(engine::Err::Io);
    esp_console_register_help_command();
    const esp_console_cmd_t cmds[] = {
        {.command = "wifi", .help = "wifi <ssid> [password] | wifi show", .hint = nullptr, .func = cmd_wifi, .argtable = nullptr, .func_w_context = nullptr, .context = nullptr},
        {.command = "token", .help = "token show | set <t> | new", .hint = nullptr, .func = cmd_token, .argtable = nullptr, .func_w_context = nullptr, .context = nullptr},
        {.command = "auth", .help = "auth open|token", .hint = nullptr, .func = cmd_auth, .argtable = nullptr, .func_w_context = nullptr, .context = nullptr},
        {.command = "hostname", .help = "hostname [name]", .hint = nullptr, .func = cmd_hostname, .argtable = nullptr, .func_w_context = nullptr, .context = nullptr},
        {.command = "status", .help = "show status", .hint = nullptr, .func = cmd_status, .argtable = nullptr, .func_w_context = nullptr, .context = nullptr},
        {.command = "fsbench", .help = "fsbench <clip>", .hint = nullptr, .func = cmd_fsbench, .argtable = nullptr, .func_w_context = nullptr, .context = nullptr},
        {.command = "lcd", .help = "lcd pins | init [spi_hz]", .hint = nullptr, .func = cmd_lcd, .argtable = nullptr, .func_w_context = nullptr, .context = nullptr},
        {.command = "bench", .help = "time the page renderer (result in the log)", .hint = nullptr, .func = cmd_bench, .argtable = nullptr, .func_w_context = nullptr, .context = nullptr},
        {.command = "page", .help = "page clock|air|day|next", .hint = nullptr, .func = cmd_page, .argtable = nullptr, .func_w_context = nullptr, .context = nullptr},
        {.command = "weather", .help = "weather | weather refresh | weather at <lat> <lon> [name]", .hint = nullptr, .func = cmd_weather, .argtable = nullptr, .func_w_context = nullptr, .context = nullptr},
        {.command = "sensor", .help = "show BME688 reading", .hint = nullptr, .func = cmd_sensor, .argtable = nullptr, .func_w_context = nullptr, .context = nullptr},
        {.command = "ack", .help = "acknowledge (snooze) the alert", .hint = nullptr, .func = cmd_ack, .argtable = nullptr, .func_w_context = nullptr, .context = nullptr},
        {.command = "reboot", .help = "reboot", .hint = nullptr, .func = cmd_reboot, .argtable = nullptr, .func_w_context = nullptr, .context = nullptr},
        {.command = "factory-reset", .help = "erase NVS settings", .hint = nullptr, .func = cmd_factory, .argtable = nullptr, .func_w_context = nullptr, .context = nullptr},
    };
    for (const auto& c : cmds) esp_console_cmd_register(&c);
    if (esp_console_start_repl(repl) != ESP_OK) return std::unexpected(engine::Err::Io);
    return {};
}

}  // namespace net
