tobiwan88/desk_notifier/firmware/components/screen/core/squirrel.cpp

#include "screen/core/squirrel.hpp"

#include <algorithm>
#include <cmath>
#include <cstdio>

#include "screen/core/draw.hpp"
#include "screen/core/friend_view.hpp"
#include "screen/core/props.hpp"
#include "screen/core/shop.hpp"
#include "screen/core/sky.hpp"

namespace screen {
namespace {

using draw::hex;
using draw::Pt;

constexpr float kPi = 3.14159265f;

// Phase of a repeating cycle, 0..1.
float ph(std::uint32_t t, std::uint32_t period) noexcept {
    return static_cast<float>(t % period) / static_cast<float>(period);
}
float wave(std::uint32_t t, std::uint32_t period) noexcept { return std::sin(2 * kPi * ph(t, period)); }

// Palette (0xRRGGBB)
constexpr std::uint32_t kFur = 0xE0873A, kFurDark = 0xB0602A, kFurLight = 0xF4AE66, kBelly = 0xFBE4C4,
                        kEarIn = 0xF4A6A0, kEye = 0x2A1810, kNose = 0x5B2B1A, kCheek = 0xFF8C9A,
                        kAcorn = 0xB37B40, kAcornCap = 0x6E4220, kMouth = 0x7A2430, kTongue = 0xF07C8A,
                        kWhite = 0xFFFFFF, kHat = 0xE0505E, kHatShade = 0xB23A48, kHatStripe = 0xFFD6DC,
                        kHatCuff = 0xF6F3EE, kHatCuffShade = 0xC9C2BA, kCone = 0xE2A85A, kConeLine = 0xB37A36,
                        kScoop = 0xFF9EC4, kScoopShade = 0xE57BA6;

// Maps squirrel design coordinates (body centre at 125,150) to the screen.
struct Pen {
    const Canvas& cv;
    float ox, oy, s;
    float X(float x) const { return ox + (x - 125.0f) * s; }
    float Y(float y) const { return oy + (y - 150.0f) * s; }
    void circle(float x, float y, float r, std::uint32_t c, int a = 256) const { draw::circle(cv, X(x), Y(y), r * s, hex(c), a); }
    void ellipse(float x, float y, float rx, float ry, std::uint32_t c, float ang = 0, int a = 256) const {
        draw::ellipse(cv, X(x), Y(y), rx * s, ry * s, hex(c), ang, a);
    }
    void line(float x0, float y0, float x1, float y1, float r, std::uint32_t c, int a = 256) const {
        draw::capsule(cv, X(x0), Y(y0), X(x1), Y(y1), r * s, hex(c), a);
    }
    void arc(float x, float y, float R, float a0, float a1, float w, std::uint32_t c) const {
        draw::arc(cv, X(x), Y(y), R * s, a0, a1, w * s, hex(c));
    }
    void quad(float x0, float y0, float x1, float y1, std::uint32_t c) const {  // axis-aligned box
        const Pt p[4] = {{X(x0), Y(y0)}, {X(x1), Y(y0)}, {X(x1), Y(y1)}, {X(x0), Y(y1)}};
        draw::polygon(cv, p, 4, hex(c));
    }
};

struct Anim {
    float dx = 0, dy = 0;   // whole body offset
    float tail = 0;         // tail rotation around its base, radians (negative = droops away)
    float ear = 0;          // extra outward ear tilt
    bool blink = false;
};

Anim animate(Mood m, std::uint32_t t, bool windy) noexcept {
    Anim a;
    switch (m) {
        case Mood::VeryGood:
            a.dy = -std::fabs(std::sin(kPi * ph(t, 700))) * 8.0f;
            a.tail = wave(t, 500) * 0.15f;
            a.ear = wave(t, 350) * 0.08f;
            break;
        case Mood::Good:
            a.dy = wave(t, 1800) * 1.8f;
            a.tail = wave(t, 2000) * 0.08f;
            a.blink = ph(t, 3700) > 0.965f;
            break;
        case Mood::Okay:
            a.dy = wave(t, 3000) * 1.2f;
            a.tail = -0.12f + wave(t, 3000) * 0.04f;
            a.ear = 0.12f;
            a.blink = ph(t, 4300) > 0.96f;
            break;
        case Mood::Bad:
            a.dx = ph(t, 2500) < 0.25f ? wave(t, 90) * 1.2f : 0.0f;  // shiver now and then
            a.tail = -0.4f;
            a.ear = 0.35f;
            break;
        case Mood::Sleepy:
            a.dy = wave(t, 3500) * 1.5f;
            a.tail = 0.05f;
            a.ear = 0.2f;
            break;
    }
    if (windy) {  // lifted off the ground by the umbrella, the tail streaming behind
        a.dy = -16.0f + wave(t, 1500) * 4.0f;
        a.dx = wave(t, 1100) * 2.5f;
        a.tail = -1.5f + wave(t, 450) * 0.15f;
        a.ear = 0.3f + wave(t, 300) * 0.1f;
        a.blink = false;
    }
    return a;
}

void tail(const Pen& p, float angle) {
    struct Puff { float x, y, r; };
    // a "?"-shaped plume: thin at the base, bushy at the top, the tip curling over towards the head
    static constexpr Puff kTail[] = {{94, 168, 11}, {78, 156, 16}, {66, 138, 21}, {60, 116, 24},
                                     {62, 92, 25},  {72, 72, 22},  {88, 60, 18},  {101, 60, 13}};
    constexpr int kN = 8;
    constexpr float bx = 100, by = 172;   // pivot at the base
    constexpr float mx = 90, my = 112;    // inside of the curl
    const float c = std::cos(angle), s = std::sin(angle);
    Puff q[kN];
    for (int i = 0; i < kN; ++i) {
        const float x = kTail[i].x - bx, y = kTail[i].y - by;
        const float k = static_cast<float>(i) / (kN - 1);  // the tip swings more than the base
        const float ci = 1 + (c - 1) * k, si = s * k;
        q[i] = {bx + x * ci - y * si, by + x * si + y * ci, kTail[i].r};
    }
    // fluffy tufts on the outer rim
    Puff tufts[kN * 3];
    int nt = 0;
    for (int i = 1; i < kN; ++i) {
        float dx = q[i].x - mx, dy = q[i].y - my;
        const float len = std::sqrt(dx * dx + dy * dy) + 1e-3f;
        dx /= len; dy /= len;
        for (int j = -1; j <= 1; ++j) {
            const float a = static_cast<float>(j) * 0.55f, ca = std::cos(a), sa = std::sin(a);
            const float ux = dx * ca - dy * sa, uy = dx * sa + dy * ca;
            tufts[nt++] = {q[i].x + ux * q[i].r * 0.88f, q[i].y + uy * q[i].r * 0.88f, q[i].r * 0.36f};
        }
    }
    for (int i = 0; i < nt; ++i) p.circle(tufts[i].x, tufts[i].y, tufts[i].r + 2.5f, kFurDark);
    for (const Puff& u : q) p.circle(u.x, u.y, u.r + 2.5f, kFurDark);
    for (int i = 0; i < nt; ++i) p.circle(tufts[i].x, tufts[i].y, tufts[i].r, kFur);
    for (const Puff& u : q) p.circle(u.x, u.y, u.r, kFur);
    // lighter streak along the inside of the curl
    for (int i = 1; i < kN; ++i) {
        const float dx = mx - q[i].x, dy = my - q[i].y;
        const float len = std::sqrt(dx * dx + dy * dy) + 1e-3f;
        p.circle(q[i].x + dx / len * q[i].r * 0.35f, q[i].y + dy / len * q[i].r * 0.35f, q[i].r * 0.45f, kFurLight, 170);
    }
}

void ear(const Pen& p, float x, float y, float ang, bool wolf = false) {
    if (wolf) {  // Halloween: tall grey wolf ears
        const float c = std::cos(ang), s = std::sin(ang);
        auto at = [&](float dx, float dy) { return Pt{p.X(x + dx * c - dy * s), p.Y(y + dx * s + dy * c)}; };
        const Pt outer[3] = {at(-10, 6), at(10, 6), at(0, -26)}, inner[3] = {at(-5.5f, 3), at(5.5f, 3), at(0, -17)};
        const Pt edge[3] = {at(-11.5f, 7), at(11.5f, 7), at(0, -28.5f)};
        draw::polygon(p.cv, edge, 3, hex(0x4A4A56));
        draw::polygon(p.cv, outer, 3, hex(0x8E8E9A));
        draw::polygon(p.cv, inner, 3, hex(0xD9A0A8));
        return;
    }
    p.ellipse(x, y, 8.5f, 15, kFurDark, ang);
    p.ellipse(x, y, 7, 13.5f, kFur, ang);
    p.ellipse(x + std::sin(-ang) * -1.5f, y + 2, 4, 8.5f, kEarIn, ang);
    // tuft at the tip
    const float tx = x + std::sin(ang) * 14, ty = y - std::cos(ang) * 14;
    p.line(tx, ty, tx + std::sin(ang) * 6, ty - std::cos(ang) * 6, 2.6f, kFurDark);
}

void eye(const Pen& p, float x, float y, Mood m, bool blink, float look = 0) {
    if (m == Mood::VeryGood) { p.arc(x, y + 3, 5, kPi + 0.35f, 2 * kPi - 0.35f, 1.7f, kEye); return; }  // ^ ^
    if (m == Mood::Sleepy) { p.arc(x, y - 3, 5, 0.35f, kPi - 0.35f, 1.5f, kEye); return; }              // closed
    if (blink) { p.line(x - 5, y + 1, x + 5, y + 1, 1.5f, kEye); return; }
    x += look * 2.2f;  // a glance to the side
    p.ellipse(x, y, 5.5f, 7, kEye);
    p.circle(x + 2, y - 2.5f, 2.2f, kWhite);
    p.circle(x - 1.5f, y + 3, 1.0f, kWhite, 190);
    x -= look * 2.2f;
    if (m == Mood::Okay) {  // half-closed lid
        p.quad(x - 7, y - 9, x + 7, y - 0.5f, kFur);
        p.line(x - 6, y - 0.5f, x + 6, y - 0.5f, 1.2f, kEye);
    }
}

void acorn(const Pen& p, float x, float y, float ang = 0) {
    p.ellipse(x, y + 2, 7, 8.5f, kAcorn, ang);
    p.circle(x - 2.5f, y + 1, 2, 0xD9A066, 160);
    p.ellipse(x, y - 4.5f, 8.5f, 4.5f, kAcornCap, ang);
    p.line(x, y - 8, x + 1.5f, y - 11.5f, 1.3f, kAcornCap);
}

// Knitted beanie with a pom-pom; the ears poke out through it.
void hat_dome(const Pen& p) {
    constexpr float cx = 125, cy = 91, rx = 32, ry = 27;
    Pt dome[13];
    for (int i = 0; i <= 12; ++i) {  // top half of an ellipse
        const float a = kPi + kPi * static_cast<float>(i) / 12;
        dome[i] = {p.X(cx + rx * std::cos(a)), p.Y(cy + ry * std::sin(a))};
    }
    draw::polygon(p.cv, dome, 13, hex(kHat));
    for (const float y : {79.0f, 71.0f}) {  // knit stripes, inset to the dome's width at that height
        const float d = (y - cy) / ry, half = rx * std::sqrt(std::max(0.0f, 1 - d * d)) - 4;
        p.line(cx - half, y, cx + half, y, 2.2f, kHatStripe, 220);
    }
}

void hat_cuff(const Pen& p, std::uint32_t t) {
    p.line(95, 90, 155, 90, 6, kHatCuffShade);
    p.line(95, 89, 155, 89, 5.2f, kHatCuff);
    for (int i = 0; i < 6; ++i) p.line(100 + i * 10.0f, 86.5f, 100 + i * 10.0f, 91.5f, 0.6f, kHatCuffShade, 170);  // ribbing
    const float bob = wave(t, 900) * 0.8f;
    p.circle(125, 62 + bob, 8, kHatCuffShade);
    p.circle(125, 61.5f + bob, 7, kHatCuff);
    p.circle(122.5f, 59 + bob, 2.5f, kWhite, 200);
}

void scarf(const Pen& p) {
    p.line(141, 131, 148, 151, 4.4f, kHatShade);
    p.line(141, 131, 148, 151, 3.6f, kHat);
    p.line(144.5f, 145, 148.5f, 144, 1.1f, kHatStripe);
    p.line(102, 129, 148, 129, 6, kHatShade);
    p.line(102, 128, 148, 128, 5.2f, kHat);
    for (int i = 0; i < 4; ++i) p.line(109 + i * 11.0f, 124, 107 + i * 11.0f, 132, 1.1f, kHatStripe, 200);
}

// Strawberry ice cream on a waffle cone, slowly melting.
void ice_cream(const Pen& p, std::uint32_t t, bool paws = true) {
    const Pt cone[3] = {{p.X(117.5f), p.Y(139)}, {p.X(132.5f), p.Y(139)}, {p.X(125), p.Y(160)}};
    draw::polygon(p.cv, cone, 3, hex(kCone));
    p.line(120, 143, 127, 151, 0.7f, kConeLine);
    p.line(130, 143, 123, 151, 0.7f, kConeLine);
    p.line(122, 141, 129, 148, 0.7f, kConeLine);
    p.line(128, 141, 121, 148, 0.7f, kConeLine);
    p.circle(125, 133, 8.5f, kScoopShade);
    p.circle(125, 132.5f, 8, kScoop);
    p.circle(119, 138.5f, 3, kScoop);
    p.circle(131, 138.5f, 3, kScoop);
    p.circle(122, 129.5f, 2.6f, kWhite, 150);
    for (int i = 0; i < 4; ++i)  // sprinkles
        p.line(120 + i * 3.5f, 133 - (i & 1) * 3.0f, 121.5f + i * 3.5f, 134 - (i & 1) * 3.0f, 0.7f, i & 1 ? 0x6FD0F0 : 0xFFE14D);
    const float k = ph(t, 2600);  // a drip running down the cone
    p.circle(131.5f, 139 + k * 9, 1.6f, kScoop, static_cast<int>(256 * (1 - k)));
    p.line(127, 124.5f, 129, 121, 0.7f, 0x3A7A2A);  // cherry
    p.circle(126.5f, 124.5f, 2.8f, 0xE53950);
    p.circle(125.7f, 123.6f, 0.9f, kWhite, 200);
    if (paws) {  // holding the cone
        p.circle(117.5f, 146, 4.2f, kFur);
        p.circle(132.5f, 146, 4.2f, kFur);
    }
}

void sunglasses(const Pen& p) {
    for (const float x : {111.0f, 139.0f}) {
        p.ellipse(x, 99, 12, 9, 0x14141C);
        p.ellipse(x - 3.5f, 95.5f, 4.5f, 2.2f, kWhite, -0.5f, 110);  // glint
    }
    p.line(122, 97.5f, 128, 97.5f, 1.4f, 0x14141C);  // bridge
    p.line(100, 96, 93, 91, 1.2f, 0x14141C);         // arms towards the ears
    p.line(150, 96, 157, 91, 1.2f, 0x14141C);
}

// Umbrella held in the right paw. tilt (radians) leans the canopy; positive = to the right.
void umbrella(const Pen& p, float tilt) {
    constexpr float hx = 165, hy = 128, len = 72, R = 54, H = 28;
    constexpr std::uint32_t kPanelA = 0x3F6FD8, kPanelB = 0x9CC0F5, kEdge = 0x24428C, kShaft = 0x4A3A30;
    const float c = std::cos(tilt), sn = std::sin(tilt);
    const float ux = sn, uy = -c;              // up along the shaft
    const float bx = hx + ux * len, by = hy + uy * len;  // canopy base centre
    auto at = [&](float lx, float ly) { return Pt{p.X(bx + lx * c + ly * ux), p.Y(by + lx * sn + ly * uy)}; };
    p.line(hx, hy, bx, by, 1.4f, kShaft);              // shaft
    p.arc(hx - 4.5f, hy, 4.5f, 0.0f, kPi, 1.4f, kShaft);  // hook
    constexpr int kSeg = 6, kStep = 4;
    for (int pass = 0; pass < 2; ++pass) {  // pass 0: dark rim, pass 1: panels
        const float r = pass == 0 ? R + 2.5f : R, h = pass == 0 ? H + 2.5f : H;
        for (int k = 0; k < kSeg; ++k) {
            Pt poly[kStep + 2];
            int n = 0;
            poly[n++] = at(0, pass == 0 ? -1.5f : 0);
            for (int j = 0; j <= kStep; ++j) {
                const float a = kPi * (static_cast<float>(k) + static_cast<float>(j) / kStep) / kSeg;
                poly[n++] = at(r * std::cos(a), h * std::sin(a));
            }
            draw::polygon(p.cv, poly, n, hex(pass == 0 ? kEdge : (k & 1 ? kPanelB : kPanelA)));
        }
    }
    p.line(bx + ux * (H + 1), by + uy * (H + 1), bx + ux * (H + 6), by + uy * (H + 6), 1.2f, kShaft);  // tip
}

void wind_streaks(const Pen& p, std::uint32_t t) {
    for (int i = 0; i < 4; ++i) {
        const float k = ph(t + static_cast<std::uint32_t>(i) * 330u, 1300);
        const float y = 64 + static_cast<float>(i) * 34 + wave(t + static_cast<std::uint32_t>(i) * 200u, 900) * 3;
        const float x = -30 + k * 230;
        const int al = static_cast<int>(200 * std::sin(kPi * k));
        p.line(x, y, x + 30 + 8.0f * static_cast<float>(i & 1), y, 1.1f, kWhite, al);
    }
}

}  // namespace

Outfit dress(Outfit o, const Look& look) noexcept {
    if (look.hat >= 0) {
        o.wear_hat = shop_item(look.hat).art;
        o.scarf = o.hat;  // keeps the scarf when it is cold
        o.hat = false;
    }
    if (look.face >= 0) o.wear_face = shop_item(look.face).art;
    if (look.body >= 0) o.wear_body = shop_item(look.body).art;
    return o;
}

Bob squirrel_bob(Mood m, std::uint32_t t) noexcept {
    const Anim a = animate(m, t, false);
    return {a.dx, a.dy};
}

Outfit outfit_for(bool weather_ok, const weather::Forecast& w) noexcept {
    Outfit o;
    if (!weather_ok) return o;
    using weather::Sky;
    o.hat = w.temp_c < kColdC;
    o.ice_cream = w.temp_c >= kHotC;
    o.sunglasses = w.is_day && (w.sky == Sky::Clear || w.sky == Sky::PartlyCloudy);
    o.windy = w.wind_kmh >= kWindyKmh;
    const auto rainy = [](Sky s) { return s == Sky::Drizzle || s == Sky::Rain || s == Sky::Thunder; };
    // Raining right now, or a rainy day code that is backed by a real chance of rain (a "drizzle" day at 0 % is dry).
    const bool rain_now = w.now_code >= 0 && rainy(weather::sky_from_wmo(w.now_code));
    const bool rain_day = rainy(w.sky) && (w.precip_pct < 0 || w.precip_pct >= kUmbrellaPct);
    o.umbrella = o.windy || rain_now || rain_day;
    if (o.umbrella) o.ice_cream = false;  // the paws hold the umbrella
    return o;
}

Mood mood_for(sensor::Level l) noexcept {
    switch (l) {
        case sensor::Level::Good: return Mood::VeryGood;
        case sensor::Level::Fair: return Mood::Good;
        case sensor::Level::Stale: return Mood::Okay;
        case sensor::Level::Poor: return Mood::Bad;
        case sensor::Level::WarmingUp: break;
    }
    return Mood::Sleepy;
}

const char* mood_label(Mood m) noexcept {
    switch (m) {
        case Mood::VeryGood: return "VERY GOOD";
        case Mood::Good: return "GOOD";
        case Mood::Okay: return "OKAY";
        case Mood::Bad: return "BAD";
        case Mood::Sleepy: return "WAKING UP";
    }
    return "";
}

void draw_squirrel(const Canvas& cv, float cx, float cy, float scale, Mood m, std::uint32_t t, Outfit o,
                   const fun::Quirks& q) noexcept {
    if (o.paws_free) o.ice_cream = o.umbrella = o.windy = false;  // indoors, paws busy
    Anim a = animate(m, t, o.windy);
    if (!o.windy) {  // the little random quirks
        a.blink = a.blink || q.blink;
        a.tail += q.tail * 0.22f;
        if (m == Mood::VeryGood || m == Mood::Good || m == Mood::Okay) a.dy -= q.hop * 6;
    }
    const float twitch = o.windy ? 0.0f : q.ear * 0.35f;
    // the ice cream replaces the acorn; a fanning (bad air) or sleeping squirrel keeps its pose
    const bool cone = o.ice_cream && !o.umbrella && (m == Mood::VeryGood || m == Mood::Good || m == Mood::Okay);
    const Pen p{cv, cx + a.dx * scale, cy + a.dy * scale, scale};

    tail(p, a.tail);

    // body, thighs, belly, feet
    p.ellipse(125, 150, 30, 35, kFurDark);
    p.ellipse(125, 150, 28, 33, kFur);
    p.ellipse(106, 167, 13, 15, kFurDark);
    p.ellipse(144, 167, 13, 15, kFurDark);
    p.ellipse(106, 167, 11.5f, 13.5f, kFur);
    p.ellipse(144, 167, 11.5f, 13.5f, kFur);
    p.ellipse(126, 157, 17, 23, kBelly);
    p.ellipse(104, 182, 13, 6, kFurDark);
    p.ellipse(148, 182, 13, 6, kFurDark);
    if (o.wear_body == 0) props::xmas_sweater(cv, p.X(125), p.Y(150), 30 * p.s, 35 * p.s, t);
    if (o.wear_body == 1) props::swim_ring(cv, p.X(125), p.Y(158), 36 * p.s, t);

    // arms and paws
    if (o.paws_free) {
        // the caller draws the arms with whatever they hold
    } else if (cone) {
        p.ellipse(114, 139, 6, 10, kFur, 0.6f);
        p.ellipse(136, 139, 6, 10, kFur, -0.6f);
    } else switch (m) {
        case Mood::VeryGood:
        case Mood::Good: {
            const float hello = o.umbrella ? 0.0f : q.wave;
            const float toss = (hello < 0.05f && m == Mood::VeryGood) ? q.toss : 0.0f;  // up in the air and caught again
            p.ellipse(114, 139, 6, 10, kFur, 0.6f);
            if (hello < 0.05f) p.ellipse(136, 139, 6, 10, kFur, -0.6f);
            acorn(p, hello < 0.05f ? 125 : 121, 141 - 46 * std::sin(kPi * toss),
                  toss > 0 ? toss * 4 * kPi : (m == Mood::VeryGood ? wave(t, 700) * 0.15f : 0.0f));
            p.circle(118, 143, 4.2f, kFur);
            if (hello < 0.05f) {
                p.circle(132, 143, 4.2f, kFur);
            } else {  // waves hello with the right paw
                const float wx = 132 + (161 - 132) * hello + wave(t, 380) * 4 * hello, wy = 143 + (104 - 143) * hello;
                p.line(139, 133, wx, wy, 5.5f, kFurDark);
                p.line(139, 133, wx, wy, 4.4f, kFur);
                p.circle(wx, wy, 6.2f, kFurDark);
                p.circle(wx, wy, 5.2f, kFur);
                p.circle(wx - 1.5f, wy - 1.5f, 1.4f, kFurLight, 200);
            }
            break;
        }
        case Mood::Okay:
            p.ellipse(103, 150, 5.5f, 11, kFur, 0.15f);
            p.ellipse(147, 150, 5.5f, 11, kFur, -0.15f);
            acorn(p, 170, 178, 0.5f);  // put down next to it
            break;
        case Mood::Bad: {
            p.ellipse(103, 150, 5.5f, 11, kFur, 0.15f);
            const float fy = 116 + wave(t, 260) * 4;  // fanning paw
            p.line(143, 137, 154, fy + 4, 5, kFurDark);
            p.line(143, 137, 154, fy + 4, 4, kFur);
            p.circle(155, fy, 5.5f, kFur);
            break;
        }
        case Mood::Sleepy:
            p.circle(117, 146, 5, kFur);
            p.circle(133, 146, 5, kFur);
            break;
    }

    // head
    if (!o.hat) {
        ear(p, 104, 76, -0.35f - a.ear, o.wolf);
        ear(p, 146, 76, 0.35f + a.ear + twitch, o.wolf);
    }
    p.ellipse(125, 103, 33, 29, kFurDark);
    p.ellipse(125, 103, 31, 27, kFur);
    p.ellipse(118, 92, 12, 7, kFurLight, -0.2f, 120);  // forehead shine
    p.ellipse(125, 114, 16, 11, kBelly);
    if (o.hat) {
        hat_dome(p);
        ear(p, 102, 72, -0.45f - a.ear, o.wolf);  // through the hat
        ear(p, 148, 72, 0.45f + a.ear + twitch, o.wolf);
        hat_cuff(p, t);
        scarf(p);
    } else if (o.scarf) {
        scarf(p);
    }
    if (m != Mood::Bad || o.hat) {  // rosy cheeks, also from the cold
        p.circle(103, 112, 6, kCheek, m == Mood::VeryGood || o.hat ? 200 : 130);
        p.circle(147, 112, 6, kCheek, m == Mood::VeryGood || o.hat ? 200 : 130);
    }
    eye(p, 112, 99, m, a.blink, q.look);
    eye(p, 138, 99, m, a.blink, q.look);
    if (o.wear_face == 0) props::party_glasses(cv, p.X(112), p.Y(99), p.X(138), p.Y(99), 9 * p.s, t);
    else if (o.sunglasses) sunglasses(p);
    if (o.wear_hat >= 0) props::shop_hat(cv, o.wear_hat, p.X(125), p.Y(80), 50 * p.s, t);
    if (m == Mood::Bad) {  // worried brows (under the hat cuff they sit lower)
        const float by = o.hat ? 4.0f : 0.0f;
        p.line(106, 90 + by, 116, 86 + by, 1.5f, kFurDark);
        p.line(134, 86 + by, 144, 90 + by, 1.5f, kFurDark);
    }

    // mouth (before the nose so the nose sits on top)
    switch (m) {
        case Mood::VeryGood:
            p.ellipse(125, 116, 7, 6.5f, kMouth);
            p.ellipse(125, 119.5f, 4, 2.5f, kTongue);
            p.quad(116, 108, 134, 115.5f, kBelly);
            p.quad(122.5f, 115.5f, 127.5f, 118.5f, kWhite);
            break;
        case Mood::Good:
            p.quad(123, 113, 127, 117, kWhite);
            p.line(125, 113, 125, 117, 0.4f, 0xC8C0B8);
            p.arc(121, 111.5f, 4, 0.2f, kPi - 0.2f, 1.1f, kEye);
            p.arc(129, 111.5f, 4, 0.2f, kPi - 0.2f, 1.1f, kEye);
            break;
        case Mood::Okay:
            p.line(120, 116, 130, 116, 1.2f, kEye);
            break;
        case Mood::Bad:
            p.arc(125, 122, 6, kPi + 0.5f, 2 * kPi - 0.5f, 1.3f, kEye);
            break;
        case Mood::Sleepy:
            p.arc(125, 112, 3, 0.4f, kPi - 0.4f, 1.0f, kEye);
            break;
    }
    if (q.howl > 0.05f) {  // a round "oo" mouth
        p.ellipse(125, 116, 4.5f, 2 + 5 * q.howl, kMouth);
        p.ellipse(125, 118 + 2 * q.howl, 2.6f, 1.2f + 1.5f * q.howl, kTongue);
    }
    p.ellipse(125, 108, 4.5f, 3.2f, kNose);
    p.circle(123.8f, 107, 1.1f, kWhite, 150);
    if (cone) ice_cream(Pen{cv, p.ox, p.oy + 1.5f * p.s, p.s * 1.3f}, t);  // 1.3x, anchored at the paws
    else if (o.ice_cream && m == Mood::Bad)  // the free paw holds it while the other one fans
        ice_cream(Pen{cv, p.ox + (101 - 125) * p.s, p.oy + 2 * p.s, p.s * 0.85f}, t);
    else if (o.ice_cream && m == Mood::Sleepy)  // put down next to it for later
        ice_cream(Pen{cv, p.ox + (170 - 125) * p.s, p.oy + 18 * p.s, p.s * 1.0f}, t, false);

    if (o.umbrella) {
        p.line(138, 141, 165, 129, 5.5f, kFurDark);  // the arm reaching out to the handle
        p.line(138, 141, 165, 129, 4.3f, kFur);
        umbrella(p, o.windy ? -0.32f + wave(t, 1700) * 0.07f : 0.06f);
        p.circle(165, 128, 4.6f, kFur);
    }
    if (o.windy) wind_streaks(p, t);

    if (m == Mood::Bad) {  // sweat drop sliding down
        const float k = ph(t, 1800), y = 84 + k * 12;
        const int al = static_cast<int>(256 * (1 - k * k));
        const Pt tri[3] = {{p.X(156.2f), p.Y(y - 0.8f)}, {p.X(162.8f), p.Y(y - 0.8f)}, {p.X(159.5f), p.Y(y - 9)}};
        draw::polygon(cv, tri, 3, hex(0x8FD3FF), al);
        p.circle(159.5f, y, 3.5f, 0x8FD3FF, al);
        p.circle(158.5f, y - 1, 1.1f, kWhite, al);
    }
}

namespace {
// The hills of a bought place (the scenery behind them is drawn by props::place_scenery).
void place_hills(int art, std::uint32_t& hill, std::uint32_t& back) {
    switch (art) {
        case props::kPlaceBeach: hill = 0xEED3A0; back = 0xF6E2B8; break;     // sand dunes
        case props::kPlaceForest: hill = 0x8EAA4E; back = 0xB4A54E; break;    // autumn grass
        case props::kPlaceBlossom: hill = 0x86CC72; back = 0xA9DC92; break;
        case props::kPlaceAlps: hill = 0x74C25A; back = 0x9CD67E; break;      // a fresh meadow
        case props::kPlaceSkyline: hill = 0x5E9E5A; back = 0x7DB06E; break;   // a city park
        default: break;
    }
}
}  // namespace

void render_air(const Canvas& cv, const AirData& d) noexcept {
    const std::uint32_t t = d.t_ms;
    const Mood m = d.sensor_ok ? mood_for(d.quality.level) : Mood::Sleepy;
    const int place = d.look && d.look->place >= 0 ? shop_item(d.look->place).art : -1;

    std::uint32_t top = 0, bottom = 0, hill = 0, hill_back = 0;
    switch (m) {
        case Mood::VeryGood: top = 0x8EDBFF; bottom = 0xE4FFF2; hill = 0x6FC75E; hill_back = 0x9AD98A; break;
        case Mood::Good: top = 0xA6D3EE; bottom = 0xEEF7EA; hill = 0x7DBD66; hill_back = 0xA5CF91; break;
        case Mood::Okay: top = 0xEBD9A6; bottom = 0xFFF5DD; hill = 0xAAB062; hill_back = 0xC8C68C; break;
        case Mood::Bad: top = 0x948BA3; bottom = 0xCBC3CD; hill = 0x85896A; hill_back = 0xA2A286; break;
        case Mood::Sleepy: top = 0x162447; bottom = 0x3B3D74; hill = 0x2C4A3B; hill_back = 0x24403A; break;
    }
    const bool wx = d.weather_ok;
    const auto& w = d.weather;
    const weather::Sky sk = weather::now_sky(w);  // the picture shows the weather right now
    const bool snowy = wx && sk == weather::Sky::Snow;
    if (wx) {
        // the sky shows the weather outside; the air quality tints it and colours the hill
        sky::Palette pal = sky::colors(sk, w.is_day, t);
        if (m == Mood::Bad) pal = {draw::lerp_rgb(pal.top, 0x8E8699, 110), draw::lerp_rgb(pal.bottom, 0xB8B0BC, 110)};
        if (d.alert) pal.top = draw::lerp_rgb(pal.top, 0xFF8A7A, static_cast<int>((wave(t, 1600) + 1) * 70));
        sky::draw(cv, sk, w.is_day, t, 200, 98, 0.55f, pal, false, d.moon_phase);
        if (d.visit.who == fun::Visitor::ShootingStar) fun::shooting_star(cv, 20, 16, 220, 100, d.visit);
        if (d.rainbow > 0) props::rainbow(cv, 40, 250, 196, 7, d.rainbow);
        if (m == Mood::Sleepy) { hill = 0x7DBD66; hill_back = 0xA5CF91; }  // the night colours come from the sky now
        if (place >= 0) { props::place_scenery(cv, place, t, w.is_day); place_hills(place, hill, hill_back); }
        if (snowy) { hill = 0xC9D8E8; hill_back = 0xE4ECF4; }
        const int gl = sky::gloom(sk);  // grey light under clouds and rain
        hill = draw::lerp_rgb(hill, 0x4A5A55, gl); hill_back = draw::lerp_rgb(hill_back, 0x4A5A55, gl);
        if (!w.is_day) { hill = draw::lerp_rgb(hill, 0x16302A, 130); hill_back = draw::lerp_rgb(hill_back, 0x16302A, 150); }
    } else {
        if (d.alert) top = draw::lerp_rgb(top, 0xFF8A7A, static_cast<int>((wave(t, 1600) + 1) * 70));
        draw::vgradient(cv, top, bottom);
        if (m == Mood::Sleepy) {
            static constexpr Pt kStars[] = {{50, 60}, {78, 32}, {176, 40}, {202, 96}, {40, 120}, {150, 22}, {205, 150}};
            for (int i = 0; i < 7; ++i) {
                const float tw = (wave(t + static_cast<std::uint32_t>(i) * 437u, 2200) + 1) * 0.5f;
                draw::sparkle(cv, kStars[i].x, kStars[i].y, 2.5f + tw * 2.5f, hex(0xFFF6C8), 120 + static_cast<int>(tw * 136));
            }
        }
        if (m == Mood::VeryGood || m == Mood::Good) {  // a little sun peeking in
            draw::circle(cv, 192, 56, 20, hex(0xFFE27A), 110);
            draw::circle(cv, 192, 56, 14, hex(0xFFD23F));
        }
        if (place >= 0) { props::place_scenery(cv, place, t, m != Mood::Sleepy); place_hills(place, hill, hill_back); }
    }

    draw::circle(cv, 30, 296, 125, hex(hill_back));
    draw::circle(cv, 125, 312, 143, hex(hill));

    if ((m == Mood::VeryGood || m == Mood::Good) && !snowy) {  // flowers on the hill
        static constexpr Pt kFlowers[] = {{30, 184}, {44, 196}, {200, 204}};
        for (int i = 0; i < 3; ++i) {
            const float sw = wave(t + static_cast<std::uint32_t>(i) * 300u, 2600) * 1.5f;
            const float x = kFlowers[i].x + sw, y = kFlowers[i].y;
            const std::uint32_t petal = (i & 1) ? 0xFFFFFF : 0xFFB6C8;
            for (int k = 0; k < 5; ++k) {
                const float an = static_cast<float>(k) * 2 * kPi / 5;
                draw::circle(cv, x + std::cos(an) * 3.2f, y + std::sin(an) * 3.2f, 2.6f, hex(petal));
            }
            draw::circle(cv, x, y, 2.2f, hex(0xFFD23F));
        }
    }

    // visitors on the hill
    const fun::Visit& v = d.visit;
    auto hill_y = [](float x) { const float dx = std::clamp(x - 125, -140.0f, 140.0f); return 312 - std::sqrt(143 * 143 - dx * dx); };
    if (v.who == fun::Visitor::Hedgehog || v.who == fun::Visitor::Snail) {
        const bool hog = v.who == fun::Visitor::Hedgehog;
        const float dir = (v.r & 1) ? 1.0f : -1.0f;
        const float k = v.k - std::sin(2 * kPi * v.k * 3) / (2 * kPi * 3) * 0.8f;  // walks, stops, walks
        const float x = hog ? (dir > 0 ? -16 + k * 272 : 256 - k * 272) : (dir > 0 ? 24 + k * 40 : 64 - k * 40);
        if (hog) props::hedgehog(cv, x, hill_y(x) + 2, 1.4f, dir, t);
        else props::snail(cv, x, hill_y(x) + 2, 1.7f, dir, t);
    }
    if ((v.who == fun::Visitor::Fox || v.who == fun::Visitor::Friend) && !d.react.active) {  // family visits
        const float k = v.k;
        auto ease = [](float e) { e = std::clamp(e, 0.0f, 1.0f); return e * e * (3 - 2 * e); };
        const float x = k < 0.15f ? -30 + 80 * ease(k / 0.15f) : k > 0.85f ? 50 - 80 * ease((k - 0.85f) / 0.15f) : 50;
        if (v.who == fun::Visitor::Fox) {
            props::fox(cv, x, hill_y(x) + 3, 1.5f, 1, t);
        } else {  // a little squirrel friend with a bow, waving
            constexpr float s = 0.42f;
            fun::Quirks fq;
            fq.wave = std::min(ease((k - 0.3f) / 0.1f), ease((0.7f - k) / 0.1f));
            fq.blink = ph(t + 777, 3100) > 0.95f;
            const float cy = hill_y(x) + 2 - 35 * s;
            draw_squirrel(cv, x, cy, s, Mood::Good, t + 1234, Outfit{}, fq);
            const Bob b = squirrel_bob(Mood::Good, t + 1234);
            props::bow(cv, x + (142 - 125 + b.dx) * s, cy + (70 - 150 + b.dy) * s, 1.0f);
        }
    }
    if (v.who == fun::Visitor::Bee) {  // from flower to flower
        const float k = v.k, a = k * 2 * kPi * 2;
        float x = 52 + std::cos(a) * 30 + std::sin(a * 2.3f) * 8, y = 170 + std::sin(a) * 18;
        if (k < 0.1f) { const float e = k / 0.1f; x = 260 - (260 - x) * e; y = 120 + (y - 120) * e; }
        if (k > 0.9f) { const float e = (k - 0.9f) / 0.1f; x += (260 - x) * e; y += (110 - y) * e; }
        props::bee(cv, x, y, 1.7f, t);
    }

    // a friend from the shop lives on the hill (unless someone else is visiting that spot)
    const fun::Visitor hv = d.visit.who;
    const bool hill_busy = hv == fun::Visitor::Fox || hv == fun::Visitor::Friend || hv == fun::Visitor::Hedgehog ||
                           hv == fun::Visitor::Snail || (d.react.active && d.react.r.action == Action::Water);
    if (d.look && d.look->buddy >= 0 && !hill_busy) {
        const float bx = 64, by = 312 - std::sqrt(143.0f * 143.0f - (bx - 125) * (bx - 125)) + 3;
        switch (shop_item(d.look->buddy).art) {
            case 0: props::hamster_wheel(cv, bx, by, 1.5f, t); break;
            case 1: props::hedgehog_sleep(cv, bx, by, 1.8f, t); break;
            case 2: props::nest(cv, bx, by, 1.7f, t); break;
            case 3:
                draw::capsule(cv, bx - 15, by - 2, bx + 15, by - 3, 4.5f, hex(0x7A5230));  // a log to sit on
                props::owl(cv, bx, by - 5, 1.5f, t);
                break;
            default: break;
        }
    }
    if (d.coin >= 0) {  // a coin glints in the grass, then hops into the squirrel's pocket
        const float k = d.coin, cx0 = 84, cy0 = 312 - std::sqrt(143.0f * 143.0f - 41.0f * 41.0f) - 4;
        const float e = std::clamp((k - 0.55f) / 0.3f, 0.0f, 1.0f);
        const float x = cx0 + (140 - cx0) * e, y = cy0 + (130 - cy0) * e - std::sin(kPi * e) * 30;
        if (k < 0.88f) {
            draw::circle(cv, x, y, 5.2f, hex(0xB8862A));
            draw::circle(cv, x, y, 4.3f, hex(0xFFD54A));
            draw::circle(cv, x - 1.3f, y - 1.3f, 1.4f, hex(0xFFFFFF), 200);
            if (k < 0.55f) draw::sparkle(cv, x + 4, y - 4, 2 + 3 * std::fabs(std::sin(static_cast<float>(t) / 150.0f)), hex(0xFFFFFF));
        } else {
            draw_text(cv, 150, static_cast<int>(100 - (k - 0.88f) * 120), 2, hex(0xFFE27A), "+1");
        }
    }

    const bool reacting = d.react.active;  // a visit from the pet page
    if (reacting) friends::back(cv, d);

    if (wx) sky::precipitation(cv, sk, t);  // in front of the hills, behind the squirrel

    // the haze of bad air drifts past, partly behind and partly in front of the squirrel
    auto haze = [&](int from, int to, int alpha) {
        for (int i = from; i < to; ++i) {
            const std::uint32_t period = 9000u + static_cast<std::uint32_t>(i) * 1700u;
            const float x = -40 + ph(t + static_cast<std::uint32_t>(i) * 2100u, period) * 320;
            const float y = 60 + static_cast<float>((i * 37) % 110) + wave(t + static_cast<std::uint32_t>(i) * 500u, 3000) * 5;
            draw::ellipse(cv, x, y, 26, 15, hex(0x7E7690), 0, alpha);
            draw::ellipse(cv, x + 16, y - 6, 17, 12, hex(0x7E7690), 0, alpha);
        }
    };
    if (m == Mood::Bad) haze(0, 3, 110);

    const Outfit outfit = outfit_for(d.weather_ok, d.weather);
    const bool bird = d.visit.who == fun::Visitor::Bird && !outfit.umbrella;
    const bool gold = d.golden >= 0 && m != Mood::Bad && !reacting;
    fun::Quirks q = d.quirks;
    if (bird) q.hop = 0;  // sits still while the bird is on its head
    Mood face = m;
    if (gold) {  // over the moon: hops for joy
        face = Mood::VeryGood;
        q.hop = std::fabs(std::sin(static_cast<float>(t) / 260.0f));
        q.wave = q.toss = 0;
        const float k = d.golden;
        const float y = k < 0.12f ? -12 + 184 * (k / 0.12f) * (k / 0.12f) : 172 - std::fabs(std::sin(std::min(1.0f, (k - 0.12f) / 0.08f) * kPi)) * 14 * (1 - std::min(1.0f, (k - 0.12f) / 0.08f));
        props::golden_acorn(cv, 86, y - 4, 2.0f, t);
    }
    Outfit look = d.look ? dress(outfit, *d.look) : outfit;
    look.wolf = d.wolf;
    friends::Pose pose{face, look, q};
    if (reacting) pose = friends::pose(d, face, look, q);
    if (pose.outfit.umbrella) draw_squirrel(cv, 144, 156, 0.78f, pose.face, t, pose.outfit, pose.q);  // smaller, canopy clear of the top text
    else draw_squirrel(cv, 146, 136, 0.92f, pose.face, t, pose.outfit, pose.q);
    if (reacting) friends::front(cv, d, pose, 146, 136, 0.92f);
    if (q.howl > 0.05f && !reacting) fun::howl_text(cv, 150, 106, 178, 128, q.howl, t);
    if (bird && !reacting) {
        const Bob b = squirrel_bob(m, t);
        constexpr float s = 0.92f;
        const bool hatted = outfit.hat || (d.look && d.look->hat >= 0);
        fun::bird_on_head(cv, 146 + (b.dx - 4) * s, 136 + (b.dy + (hatted ? 52 : 76) - 150) * s, 1.2f, d.visit, t);
    }
    if (d.visit.who == fun::Visitor::Butterfly && !reacting) fun::butterfly(cv, 14, 50, 150, 170, d.visit, t);
    if (d.visit.who == fun::Visitor::Leaves) props::falling_leaves(cv, d.visit.k, t, d.visit.r);
    if (d.visit.who == fun::Visitor::Petals) props::petals(cv, d.visit.k, t, d.visit.r);

    if (m == Mood::Bad) haze(3, 5, 70);
    if (m == Mood::VeryGood) {
        static constexpr Pt kSpark[] = {{52, 64}, {206, 146}, {40, 150}, {186, 40}};
        for (int i = 0; i < 4; ++i) {
            const float tw = std::fabs(wave(t + static_cast<std::uint32_t>(i) * 330u, 1400));
            draw::sparkle(cv, kSpark[i].x, kSpark[i].y, 3 + tw * 6, hex(i & 1 ? 0xFFFFFF : 0xFFF07A), static_cast<int>(tw * 256));
        }
    }
    if (m == Mood::Sleepy) {  // Zzz
        for (int i = 0; i < 3; ++i) {
            const float k = ph(t + static_cast<std::uint32_t>(i) * 1000u, 3000);
            if (k > 0.85f) continue;
            draw_text(cv, static_cast<int>(174 + k * 12), static_cast<int>(82 - k * 34), 1 + (k > 0.3f) + (k > 0.6f),
                      hex(0xE8E8FF), "Z");
        }
    }

    // soft dark plates behind the text, so it reads on bright snow and sky as well
    auto plate = [&](int y, int h, int w) {
        draw::capsule(cv, 120 - w / 2.0f, y + h / 2.0f, 120 + w / 2.0f, y + h / 2.0f, h / 2.0f + 3, hex(0x1A2233), 70);
    };
    plate(22, 14, 116);
    plate(180, 42, 136);

    const auto white = hex(kWhite);
    char buf[24];
    if (d.sensor_ok) {
        std::snprintf(buf, sizeof buf, "%.1f^C %.0f%%", static_cast<double>(d.reading.temp_c), static_cast<double>(d.reading.rh));
        draw::label(cv, 22, 2, white, buf);
    } else {
        draw::label(cv, 22, 2, white, "NO SENSOR");
    }
    if (reacting) {
        friends::labels(cv, d);
        return;
    }
    if (gold) {
        draw::label(cv, 186, 2, hex(0xFFE27A), "GOLDEN ACORN!");
        std::snprintf(buf, sizeof buf, "FOUND: %d", d.golden_count);
        draw::label(cv, 208, 2, white, buf);
        return;
    }
    if (m == Mood::Bad && ph(t, 4000) > 0.5f) draw::label(cv, 186, 2, hex(0xFFE0DA), "OPEN WINDOW");
    else {
        const char* lbl = mood_label(m);
        const bool big = text_width(lbl, 3) <= 140;  // long words get the smaller size to fit the round edge
        draw::label(cv, big ? 180 : 186, big ? 3 : 2, white, lbl);
    }
    if (d.sensor_ok && m != Mood::Sleepy) {
        std::snprintf(buf, sizeof buf, "AIR %d", d.quality.score);
        draw::label(cv, 208, 2, white, buf);
    }
}

}  // namespace screen
