tobiwan88/desk_notifier/firmware/components/screen/core/sky.cpp

#include "screen/core/sky.hpp"

#include <cmath>

#include "screen/core/draw.hpp"

namespace screen::sky {
namespace {

using draw::hex;
using draw::Pt;
using weather::Sky;

constexpr float kPi = 3.14159265f;
float ph(std::uint32_t t, std::uint32_t period) noexcept {
    return static_cast<float>(t % period) / static_cast<float>(period);
}
float wave(std::uint32_t t, std::uint32_t period) noexcept { return std::sin(2 * kPi * ph(t, period)); }
std::uint32_t tt(std::uint32_t t, int i, std::uint32_t step) noexcept { return t + static_cast<std::uint32_t>(i) * step; }

Palette base_colors(Sky s, bool day) noexcept {
    switch (s) {
        case Sky::Clear: return day ? Palette{0x3FA9F5, 0xBDE8FF} : Palette{0x0B1A3A, 0x2E3570};
        case Sky::PartlyCloudy: return day ? Palette{0x5AB4EE, 0xCDEBFA} : Palette{0x14234A, 0x353C6E};
        case Sky::Cloudy: return day ? Palette{0x8A9DB2, 0xCBD5DF} : Palette{0x343E52, 0x5D6779};
        case Sky::Fog: return day ? Palette{0xA3ADB8, 0xDDE2E6} : Palette{0x4A5260, 0x737B88};
        case Sky::Drizzle:
        case Sky::Rain: return day ? Palette{0x56687D, 0x93A2B2} : Palette{0x2A3546, 0x4C5868};
        case Sky::Snow: return day ? Palette{0x93AAC2, 0xE6EDF5} : Palette{0x3A4A63, 0x7C8DA6};
        case Sky::Thunder: return {0x262B38, 0x535B73};
    }
    return {0x3FA9F5, 0xBDE8FF};
}

void sun(const Canvas& cv, float cx, float cy, float r, std::uint32_t t) {
    const float k = r / 26.0f;  // detail scale
    draw::circle(cv, cx, cy, r + 13 * k, hex(0xFFE680), 60);
    const float rot = ph(t, 12000) * 2 * kPi;
    for (int i = 0; i < 10; ++i) {
        const float a = rot + static_cast<float>(i) * 2 * kPi / 10;
        const float len = ((i & 1) ? 10.0f : 14.0f) * k, r0 = r + 5 * k;
        draw::capsule(cv, cx + std::cos(a) * r0, cy + std::sin(a) * r0, cx + std::cos(a) * (r0 + len),
                      cy + std::sin(a) * (r0 + len), 2.4f * k, hex(0xFFC93C));
    }
    draw::circle(cv, cx, cy, r, hex(0xFFD23F));
    draw::circle(cv, cx - r * 0.3f, cy - r * 0.3f, r * 0.45f, hex(0xFFF0A0), 140);
    // a happy little face
    const float e = r * 0.33f;
    if (ph(t, 4100) > 0.96f) {
        draw::capsule(cv, cx - e - 2.5f * k, cy - 2 * k, cx - e + 2.5f * k, cy - 2 * k, 1.2f * k, hex(0x6B3A12));
        draw::capsule(cv, cx + e - 2.5f * k, cy - 2 * k, cx + e + 2.5f * k, cy - 2 * k, 1.2f * k, hex(0x6B3A12));
    } else {
        draw::ellipse(cv, cx - e, cy - 3 * k, 2.4f * k, 3.2f * k, hex(0x6B3A12));
        draw::ellipse(cv, cx + e, cy - 3 * k, 2.4f * k, 3.2f * k, hex(0x6B3A12));
    }
    draw::arc(cv, cx, cy + 1 * k, r * 0.38f, 0.5f, kPi - 0.5f, 1.3f * k, hex(0x6B3A12));
    draw::circle(cv, cx - r * 0.55f, cy + 3 * k, 3.2f * k, hex(0xFF9A6B), 150);
    draw::circle(cv, cx + r * 0.55f, cy + 3 * k, 3.2f * k, hex(0xFF9A6B), 150);
}

// phase < 0: the classic crescent; else 0 new .. 0.5 full .. 1 new, lit from the right while waxing.
void moon(const Canvas& cv, float cx, float cy, float r, std::uint32_t sky_at_moon, float phase) {
    if (phase < 0) {
        draw::circle(cv, cx, cy, r * 1.4f, hex(0xFFF1B0), 30);
        draw::circle(cv, cx, cy, r, hex(0xFFF1B0));
        draw::circle(cv, cx + r * 0.45f, cy - r * 0.3f, r * 0.82f, hex(sky_at_moon));
        return;
    }
    const float lit = (1 - std::cos(2 * kPi * phase)) / 2;  // 0 new .. 1 full
    draw::circle(cv, cx, cy, r * 1.4f, hex(0xFFF1B0), static_cast<int>(10 + 30 * lit));
    draw::circle(cv, cx, cy, r, hex(draw::lerp_rgb(sky_at_moon, 0xFFF1B0, 50)));  // the dark side, faintly
    const float side = phase < 0.5f ? 1.0f : -1.0f, k = std::cos(2 * kPi * phase);  // terminator: x = side * k * limb
    constexpr int kN = 7;  // 16 points: the most draw::polygon takes; each row is one span, so a crescent works
    draw::Pt pts[2 * kN + 2];
    int n = 0;
    for (int i = 0; i <= kN; ++i) {  // the lit limb, top to bottom
        const float a = -kPi / 2 + kPi * static_cast<float>(i) / kN;
        pts[n++] = {cx + side * r * std::cos(a), cy + r * std::sin(a)};
    }
    for (int i = kN; i >= 0; --i) {  // back up along the terminator
        const float a = -kPi / 2 + kPi * static_cast<float>(i) / kN;
        pts[n++] = {cx + side * k * r * std::cos(a), cy + r * std::sin(a)};
    }
    if (lit > 0.02f) draw::polygon(cv, pts, n, hex(0xFFF1B0));
    if (lit > 0.6f) {  // a few craters on a fuller moon
        draw::circle(cv, cx - r * 0.25f, cy - r * 0.2f, r * 0.18f, hex(0xEADCA0), static_cast<int>(200 * lit));
        draw::circle(cv, cx + r * 0.3f, cy + r * 0.3f, r * 0.12f, hex(0xEADCA0), static_cast<int>(200 * lit));
    }
}

void stars(const Canvas& cv, std::uint32_t t) {
    static constexpr Pt kStars[] = {{48, 70}, {76, 40}, {178, 36}, {204, 92}, {36, 116}, {150, 24}, {200, 140}, {64, 150}};
    for (int i = 0; i < 8; ++i) {
        const float tw = (wave(tt(t, i, 517), 2600) + 1) * 0.5f;
        draw::sparkle(cv, kStars[i].x, kStars[i].y, 2 + tw * 2.5f, hex(0xFFF6D0), 100 + static_cast<int>(tw * 150));
    }
}

void cloud(const Canvas& cv, float cx, float cy, float k, std::uint32_t color, std::uint32_t shade) {
    struct C { float x, y, r; };
    static constexpr C kPuffs[] = {{-22, 4, 14}, {-5, -8, 19}, {15, -2, 15}, {27, 6, 11}};
    for (int pass = 0; pass < 2; ++pass) {
        const float off = pass == 0 ? 3.0f * k : 0.0f;
        const auto c = hex(pass == 0 ? shade : color);
        for (const C& p : kPuffs) draw::circle(cv, cx + p.x * k, cy + p.y * k + off, p.r * k, c);
        draw::capsule(cv, cx - 23 * k, cy + 10 * k + off, cx + 27 * k, cy + 10 * k + off, 9 * k, c);
    }
    draw::circle(cv, cx - 9 * k, cy - 12 * k, 7 * k, hex(0xFFFFFF), 110);
}

void rain(const Canvas& cv, std::uint32_t t, int drops, float len, std::uint32_t color) {
    for (int i = 0; i < drops; ++i) {
        const std::uint32_t period = 650u + static_cast<std::uint32_t>(i % 4) * 90u;
        const float p = ph(tt(t, i, 211), period);
        const float x0 = 28 + static_cast<float>((i * 53) % 190);
        const float y = 40 + p * 210, x = x0 - p * 18;
        draw::capsule(cv, x, y, x - len * 0.25f, y + len, 1.3f, hex(color), 200);
    }
}

void snow(const Canvas& cv, std::uint32_t t) {
    for (int i = 0; i < 26; ++i) {
        const std::uint32_t period = 4200u + static_cast<std::uint32_t>(i % 5) * 800u;
        const float p = ph(tt(t, i, 389), period);
        const float x = 14 + static_cast<float>((i * 97) % 212) + wave(tt(t, i, 300), 2200) * 6;
        const float y = 30 + p * 220;
        const float r = 1.8f + static_cast<float>(i % 3) * 0.9f;
        if (i % 6 == 0) draw::sparkle(cv, x, y, r * 2.4f, hex(0xFFFFFF), 230);
        else draw::circle(cv, x, y, r, hex(0xFFFFFF), 235);
    }
}

void bolt(const Canvas& cv, float x, float y, float k) {
    const Pt a[4] = {{x + 4 * k, y}, {x + 13 * k, y}, {x + 5 * k, y + 16 * k}, {x - 4 * k, y + 16 * k}};
    const Pt b[3] = {{x - 4 * k, y + 14 * k}, {x + 12 * k, y + 14 * k}, {x - 2 * k, y + 36 * k}};
    draw::polygon(cv, a, 4, hex(0xFFE14D));
    draw::polygon(cv, b, 3, hex(0xFFE14D));
}

}  // namespace

bool lightning(Sky s, std::uint32_t t) noexcept {
    const float p = ph(t, 3200);
    return s == Sky::Thunder && (p < 0.06f || (p > 0.1f && p < 0.13f));
}

Palette colors(Sky s, bool day, std::uint32_t t) noexcept {
    Palette p = base_colors(s, day);
    if (lightning(s, t)) p = {draw::lerp_rgb(p.top, 0xFFFFFF, 140), draw::lerp_rgb(p.bottom, 0xFFFFFF, 110)};
    return p;
}

int gloom(Sky s) noexcept {
    switch (s) {
        case Sky::Clear: case Sky::PartlyCloudy: case Sky::Snow: return 0;
        case Sky::Cloudy: return 50;
        case Sky::Fog: case Sky::Drizzle: return 70;
        case Sky::Rain: return 95;
        case Sky::Thunder: return 125;
    }
    return 0;
}

void precipitation(const Canvas& cv, Sky s, std::uint32_t t) noexcept {
    switch (s) {
        case Sky::Drizzle: rain(cv, t, 10, 5, 0xBFE3FF); break;
        case Sky::Rain: rain(cv, t, 22, 9, 0xA8D8FF); break;
        case Sky::Thunder: rain(cv, t, 16, 9, 0x9CC7F0); break;
        case Sky::Snow: snow(cv, t); break;
        case Sky::Fog:
            for (int i = 0; i < 4; ++i) {
                const float y = 128 + static_cast<float>(i) * 22, dx = wave(tt(t, i, 1300), 7000) * 18;
                draw::capsule(cv, -20 + dx, y, 260 + dx, y, 9, hex(0xE8ECEF), 90);
            }
            break;
        default: break;
    }
}

void draw(const Canvas& cv, Sky s, bool day, std::uint32_t t, float icx, float icy, float k, const Palette& pal, bool precip,
          float moon_phase) noexcept {
    draw::vgradient(cv, pal.top, pal.bottom);
    const float drift = wave(t, 7000) * 5 * k;
    // sky colour behind the moon, for the crescent cut-out
    const auto behind = [&](float y) { return draw::lerp_rgb(pal.top, pal.bottom, static_cast<int>(y * 256 / 240)); };
    switch (s) {
        case Sky::Clear:
            if (day) sun(cv, icx, icy, 26 * k, t);
            else { stars(cv, t); moon(cv, icx, icy, 24 * k, behind(icy), moon_phase); }
            break;
        case Sky::PartlyCloudy:
            if (day) sun(cv, icx + 20 * k, icy - 12 * k, 21 * k, t);
            else { stars(cv, t); moon(cv, icx + 20 * k, icy - 12 * k, 19 * k, behind(icy - 12 * k), moon_phase); }
            cloud(cv, icx - 10 * k + drift, icy + 12 * k, 1.0f * k, 0xFFFFFF, 0xC9D6E3);
            break;
        case Sky::Cloudy:
            cloud(cv, icx + 22 * k - drift, icy - 12 * k, 0.8f * k, 0xD5DDE6, 0xA9B6C4);
            cloud(cv, icx - 8 * k + drift, icy + 8 * k, 1.05f * k, 0xF4F7FA, 0xBCC8D4);
            break;
        case Sky::Fog: {
            cloud(cv, icx + drift, icy, 1.0f * k, 0xE9EDF1, 0xB6C0CA);
            for (int i = 0; i < 4; ++i) {
                const float y = icy + (18 + static_cast<float>(i) * 13) * k, dx = wave(tt(t, i, 900), 5000) * 12 * k;
                const float inset = static_cast<float>(i % 2);
                draw::capsule(cv, icx + (-70 + inset * 14) * k + dx, y, icx + (70 - inset * 20) * k + dx, y, 4 * k,
                              hex(0xF2F4F6), 150);
            }
            break;
        }
        case Sky::Drizzle:
            if (precip) rain(cv, t, 10, 5, 0xBFE3FF);
            cloud(cv, icx + drift, icy, 1.05f * k, 0xE4EAF0, 0xA6B3C1);
            break;
        case Sky::Rain:
            if (precip) rain(cv, t, 22, 9, 0xA8D8FF);
            cloud(cv, icx + drift, icy, 1.1f * k, 0xC9D2DC, 0x8E9BAA);
            break;
        case Sky::Snow:
            if (precip) snow(cv, t);
            cloud(cv, icx + drift, icy - 4 * k, 1.0f * k, 0xF4F7FA, 0xC2CEDA);
            break;
        case Sky::Thunder:
            if (precip) rain(cv, t, 16, 9, 0x9CC7F0);
            if (lightning(s, t)) bolt(cv, icx - 4 * k, icy + 18 * k, k);
            cloud(cv, icx + drift, icy, 1.15f * k, 0x7D8798, 0x555E6E);
            break;
    }
}

}  // namespace screen::sky
