tobiwan88/desk_notifier/firmware/components/screen/core/squirrel.hpp

// screen: the air page. A cute squirrel mascot shows the indoor air quality with its mood, in front of the
// outdoor weather, dressed for the outdoor temperature. Pure C++.
#pragma once

#include <cstdint>

#include "screen/core/bond.hpp"
#include "screen/core/font.hpp"
#include "screen/core/memory.hpp"
#include "screen/core/fun.hpp"
#include "sensor/core/airq.hpp"
#include "weather/core/forecast.hpp"

namespace screen {

struct Look;  // screen/core/shop

// Sleepy: sensor warming up or missing. The other four follow the air-quality levels.
enum class Mood : std::uint8_t { Sleepy, VeryGood, Good, Okay, Bad };

[[nodiscard]] Mood mood_for(sensor::Level l) noexcept;
[[nodiscard]] const char* mood_label(Mood m) noexcept;  // "VERY GOOD", "GOOD", "OKAY", "BAD", ...

// What the squirrel wears for the outdoor weather. Items stack: a knitted hat and scarf below kColdC, an ice
// cream from kHotC on, sunglasses on a sunny day, an umbrella in rain (always when windy), and from kWindyKmh on
// it glides under the umbrella instead of standing.
struct Outfit {
    bool hat = false;
    bool ice_cream = false;
    bool sunglasses = false;
    bool umbrella = false;
    bool windy = false;
    bool paws_free = false;  // no arms, acorn, ice cream or umbrella: the caller draws what the paws hold
    bool wolf = false;       // Halloween night: grey wolf ears
    // bought in the shop (screen/core/shop): the drawing index, -1 = none. A bought hat replaces the knitted one;
    // `scarf` keeps the scarf on cold days.
    int wear_hat = -1, wear_face = -1, wear_body = -1;
    bool scarf = false;
};
inline constexpr float kColdC = 8.0f, kHotC = 25.0f, kWindyKmh = 30.0f;
inline constexpr int kUmbrellaPct = 40;  // a rainy day code only counts from this chance of precipitation (-1 = unknown counts)
[[nodiscard]] Outfit outfit_for(bool weather_ok, const weather::Forecast& w) noexcept;

struct AirData {
    bool sensor_ok = false;
    sensor::Reading reading{};
    sensor::Quality quality{};
    bool alert = false;      // poor air and not snoozed: the background pulses
    bool weather_ok = false; // the sky behind the squirrel shows the outdoor weather
    weather::Forecast weather{};
    std::uint32_t t_ms = 0;  // monotonic, drives the animation
    fun::Quirks quirks{};    // blinks, glances, waves ...
    fun::Visit visit{};      // a bird on the head, a butterfly, a shooting star
    float moon_phase = -1;   // 0..1 for the real moon, -1 = a crescent
    int rainbow = 0;         // 0..256: a rainbow behind the hill after rain
    float golden = -1;       // the golden acorn's visit 0..1, or -1
    int golden_count = 0;
    bool wolf = false;       // Halloween night
    ReactionNow react{};     // a visit from the pet page
    int level = 0;           // friendship level 0..4
    char pet_name[12] = "";
    Plant plant{};           // shown when it is watered
    const Look* look = nullptr;  // shop items it has around today (nullptr = none)
    float coin = -1;         // a coin found in the grass: progress 0..1, or -1
};

// Draws the squirrel. (cx, cy) is the centre of its body, `scale` 1.0 is about 120 px tall.
void draw_squirrel(const Canvas& cv, float cx, float cy, float scale, Mood m, std::uint32_t t_ms, Outfit o = {},
                   const fun::Quirks& q = {}) noexcept;

// Puts on what the squirrel picked from its shop items today (screen/core/shop Look).
[[nodiscard]] Outfit dress(Outfit o, const Look& look) noexcept;

// Where draw_squirrel moves the body this frame (the bob of the mood animation), in design units (multiply by
// scale), so that props drawn by the caller move with it.
struct Bob { float dx, dy; };
[[nodiscard]] Bob squirrel_bob(Mood m, std::uint32_t t_ms) noexcept;

void render_air(const Canvas& cv, const AirData& d) noexcept;

}  // namespace screen
