tobiwan88/desk_notifier/firmware/components/screen/core/bond.cpp

// screen: the friendship, see bond.hpp. Pure C++.
#include "screen/core/bond.hpp"

#include <algorithm>
#include <cstdio>

namespace screen {

namespace {
constexpr const char* kActions[] = {"feed", "coffee", "party", "pet", "play", "water", "goodnight", "gift"};
constexpr int kLevelStart[] = {0, 20, 40, 60, 80};
}  // namespace

const char* action_name(Action a) noexcept { return kActions[static_cast<int>(a) % kActionCount]; }

std::optional<Action> action_from_name(std::string_view s) noexcept {
    for (int i = 0; i < kActionCount; ++i)
        if (s == kActions[i]) return static_cast<Action>(i);
    return std::nullopt;
}

const char* treat_name(int i) noexcept {
    static constexpr const char* k[] = {"acorn", "hazelnut", "berry"};
    return k[std::clamp(i, 0, kTreatCount - 1)];
}

const char* gift_name(int i) noexcept {
    static constexpr const char* k[] = {"flower", "pebble", "feather", "shell", "pinecone", "heart"};
    return k[std::clamp(i, 0, kGiftCount - 1)];
}

const char* level_name(int l) noexcept {
    static constexpr const char* k[] = {"SHY", "FRIENDLY", "FRIEND", "BEST FRIEND", "FAMILY"};
    return k[std::clamp(l, 0, kLevels - 1)];
}

void settle(Bond& b, int day) noexcept {
    if (b.last_day == 0) return;
    const int from = std::max(b.settled, b.last_day + kGraceDays);
    if (day <= from) return;
    const int floor = kLevelStart[std::clamp(b.best, 0, kLevels - 1)];
    b.score = std::max(floor, b.score - (day - from));
    b.settled = day;
}
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
