tobiwan88/desk_notifier/(commit log)

2026-10-10 S0.2: firmware skeleton builds for esp32c61, Kconfig + pin static_asserts, idf-env helper
    [partitions.csv]
2026-10-10 S3.1-S3.4, S2.2, S4.2: eyes renderer+model, scene, strip pool, render task running on device
2026-10-10 S4.1, S4.3, S4.4: JSON parser, net (wifi/mdns/console), web API, NVS settings; fix IRAM-unsafe SPI isr flag
    [console.cpp, display.cpp, net.cpp, net.hpp]
2026-10-10 S4.5, S5.1-S5.6, S6.1, S6.2: clipprep, clip core+player, storage, clip routes, eyesctl, mock device, eyes-studio
2026-10-10 S7.1: OTA + rollback verified on device; crash-on-boot test option
2026-10-10 fix: identical spec-timed reset/init for both GC9A01 panels; lcd swap/init/test diagnostics
    The left panel (panel 0, owner of the shared RST line) got SLPOUT 10 ms after the
    reset pulse and its MADCTL/COLMOD/vendor gate-timing table ~110 ms after it, i.e. inside
    the GC9A01 120 ms reset-cancel window on any warm reboot; the right panel was initialised
    after it. Both panels now get: RST pulse, 120 ms, SWRESET, 120 ms, init.
    Host regression test: dirty-row strips reproduce the full render identically for
    eye 0 and eye 1 (renderer/dirty-row path ruled out).
    Console: lcd swap [on|off], lcd init [spi_hz], lcd test [seconds].
    [console.cpp, display.cpp, display.hpp]
2026-10-10 lcd test: red/blue panel patterns with L/R letters; lcd pins idle-level probe
2026-10-10 docs: wiring and GPIO map (right CS on GPIO7), CS_R default 7, allow GPIO7 in pin checks
2026-10-10 notes: second board, re-init after cabling changes
2026-10-10 record last 8 reset reasons in NVS, expose in /api/status and console status
    [console.cpp, web.cpp]
2026-10-10 random pool (anims + clips, interval), /api/pool, eyesctl add/pool, web page clips+pool sections, SPI 40 MHz, list() on heap
2026-10-10 web: serve clip_encoder.js; in-browser GIF to clip (page + encoder + node/pytest byte-identity test)
2026-10-10 cat_eyes: add 19 fx animations (food, fly, plane, bubble, spiral, slots, euro, fish, rain, snow, leaf, day/night, paw, spider, loading, pacman, matrix, disco, pumpkin)
    Claude-Session: https://claude.ai/code/session_01D9ghFqyifPXdJMtqmev7jy
2026-10-10 pool: cover all 31 animations (32-bit mask, special slot from list size, effect weights)
    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
2026-10-11 desk: single display, BME688 sensor, SNTP clock, home screen, sensor/ack API
2026-10-11 desk: BME688 retry+I2C scan (default 0x77), mirror-X option
2026-10-11 docs: README for the desk notifier, CLAUDE.md board notes
2026-10-11 Rotating pages: squirrel air mascot and Munich weather
    - Screen rotates clock / air / weather pages with a fade, at 10 fps
    - Air page: animated squirrel whose mood follows the air level
    (very good, good, okay, bad; sleepy while the sensor warms up)
    - Weather page: today's Open-Meteo forecast with animated sun, moon,
    clouds, rain, snow, fog or thunder, plus outdoor temperature
    - Anti-aliased shape rasterizer (integer per pixel, the C61 has no FPU)
    - Weather fetch task (PSRAM stack); GET/POST /api/weather,
    POST /api/page; console `page` and `weather`; Kconfig for page
    times, frame rate and location
    - Button: snooze during an alert, otherwise next page
    - Host tests for parsing, rotation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
2026-10-11 Squirrel in the weather: outdoor sky behind it, hat when cold, ice cream when hot
    - Air page sky shows the outdoor weather (sun, moon and stars, clouds,
    rain, snow with a white hill, fog mist, thunderstorm with lightning);
    the hill darkens under rain and storms; bad air greys the sky
    - Below 8 C outside: knitted hat with pom-pom and scarf; from 25 C:
    melting strawberry ice cream (both paws, the free paw while fanning,
    or put down next to the sleeping squirrel)
    - Sky drawing shared by the weather page and the air page (screen/core/sky)
    - Text plates so labels read on bright snow and sky
    - Preview `matrix`: sheets for every weather x air level x day/night x
    temperature; host test ren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
    [draw.hpp, pages.cpp, sky.cpp, sky.hpp, squirrel.cpp, squirrel.hpp]
2026-10-12 Replace the weather page with the squirrel's day
    The weather page repeated the air page's sky and the clock page's outdoor
    temperature. Its remaining numbers (low, high, chance of rain) move to the
    clock page.
    The new day page shows the squirrel at its desk at home doing what fits the
    time: coffee in the morning, laptop, lunch, closing the laptop with a stretch,
    reading under a lamp, asleep in bed. activity_for() picks the scene from
    weekday and time only (no randomness); weekends sleep in and have no work.
    The window shows the real sky, the wall clock the real time. Times are
    Kconfig options (DESK_DAY_*). "weather" stays an alias for the page name.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
    [console.cpp, day.cpp, day.hpp, pages.cpp, pages.hpp, screen_task.cpp]
2026-10-12 Day page: react to the room's climate, the weather and special days
    scene_for() now combines the daily routine with a Situation and an Occasion,
    all deterministic:
    - Indoor climate: a sudden air-score drop (AirTrend, 15 points in 30 min)
    makes it hold its nose; stale air opens the window when it is pleasant
    outside, else it yawns at work; a warm room is aired in the evening when
    outside is cooler; too warm (leaf fan), too cold (shawl and tea), too humid
    (steamed window, mushroom), too dry (water, plant mister).
    - Weather: umbrella on rainy work mornings, cocoa on wet evenings, hiding
    under the blanket in thunder, watering plants on sunny days off; rain,
    frost, fog, leaves and a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
2026-10-12 day_view: compare caption labels via string_view (fixes -Werror=string-compare)
    [day_view.cpp]
2026-10-13 Little random surprises: squirrel quirks and visitors
    The scene itself stays deterministic; inside it small things now happen at
    random moments (a stateless hash of the time slot and a seed taken from
    esp_random() at boot, so tests can replay it):
    - the squirrel blinks (sometimes twice), glances aside, twitches an ear,
    flicks its tail, hops, waves hello, and tosses its acorn in very good air
    - on the full hour the clock-page squirrel pops up and waves
    - visitors about every other minute: a blue tit on the squirrel's head or
    the window sill, a butterfly, a ladybug on the desk, a moth at the reading
    lamp, a shooting star on clear nights
    Preview clips fun_* start where the surprise happ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
    [day.cpp, day.hpp, day_view.cpp, fun.cpp, fun.hpp, pages.cpp, pages.hpp]
2026-10-13 More surprises: moon, golden acorn, seasonal visitors, rainbows, plant, countdowns, gags, puns
    - The moon shows its real phase; on full-moon and Halloween nights the
    squirrel howls now and then, with wolf ears on Halloween.
    - A rare golden acorn (about once in a day and a half) pins the air page;
    the number found is kept in NVS.
    - Seasonal visitors: an owl in the night window, a hedgehog on autumn
    evenings, snails after rain, bees in summer, falling leaves in autumn,
    blossom petals in April.
    - Rainbows when the sun comes out within 90 min after rain. The forecast
    now keeps the current weather code; the pictures show the weather now,
    the outfit still follows the day.
    - The window-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
2026-10-13 hardware: plan and phase 0 toy chain (schematic, PCB, Freerouting, DRC)
    Schematic generator layer over kicad-sch-api with a net-intent check, netlist to PCB via
    pcbnew, headless Freerouting round trip (JAR, analytics off), kicad-cli ERC/DRC JSON.
2026-10-13 hardware: notifier-v1 board (ESP32-S3, BME688, USB-C, GC9A01 header), routed and checked
    Generated schematic and 4-layer layout, routed with KiCadRoutingTools (planes on In1/In2,
    signals outer only), ERC/DRC/pin-map gate (scripts/hw-check.sh), live JLC BOM check,
    annotated review renders for agent review, JLC fab package. Firmware gets a board choice
    (DESK_BOARD_NOTIFIER_V1) with the S3 pin map and per-target reserved-pin checks.
    [notifier-v1.kicad_pcb, notifier-v1.kicad_sch]
2026-10-13 hardware: notifier-v1 rev after design review (buck, sensor peninsula, no via-in-pad)
    Review findings applied: TLV62569 buck instead of AMS1117 (0.6 W into the sensor), 500 mA
    polyfuse, BME688 on a peninsula with the neck away from the module, custom DRC rule and
    KRT settings against vias in SMD pads, signals on the outer layers only, display socket
    face past the edge with pin names, more debug pads, antenna strip without pours/vias.
    Safe cleanup of router leftovers, one-command pipeline, order checklist.
    [notifier-v1.kicad_pcb, notifier-v1.kicad_sch]
2026-10-13 hardware: tool setup script, uv run --package desk-hardware
    A fresh checkout had no router tools and no hardware Python deps (plain uv run
    only syncs the root project). setup_tools.sh installs KiCadRoutingTools v0.23.0
    and the Freerouting 2.5.0 JAR (sha256 checked); route_krt.sh says so when missing.
    [checks.py, fab_package.py, notifier_v1.py, review_pack.py]
2026-10-14 hardware: SHT40 for temperature/humidity next to the BME688
    The BME688's gas heater warms it, so T/RH come from an SHT40-AD1B (C2909890, 0x44)
    in the far corner of the sensor island (about 6 mm away, no pour between them).
    The island grows to 11.8 mm with a wider neck; C9->VDD/VSS and SDA/SCL stubs are
    hand-drawn because the SHT4x pads are 0.3 mm apart. 3V3/GND track width 0.2 mm
    (planes carry the current). finish.py keeps SWIG boards alive between iterations
    (an intermittent crash left a dangling via).
    [notifier-v1.kicad_pcb, notifier-v1.kicad_sch]
2026-10-14 Hostname from Kconfig: DESK_HOSTNAME (default squirrel)
    Replaces the desk-<MAC> default with a Kconfig string so the mDNS and
    DHCP name is set in menuconfig. An NVS override (UART console
    'hostname') still wins.
    [net.cpp]
2026-10-15 hardware: one KiCad project to review
    The pipeline left five extra projects (v1-placed and the router stages, none with a
    schematic), and KiCad kept reopening v1-placed. Router stages now live in a temp dir
    (logs in out/route/), the unrouted copy is a bare .kicad_pcb, hardware/open.sh opens
    notifier-v1, and hardware/README.md says where everything is.
2026-10-15 hardware: kicad-hw-design skill, cleanup, long-term direction
    Skill (.claude/skills/kicad-hw-design): workflow, adding a part, design rules
    learned, agent roles, and a symptom/cause/fix table of every pitfall hit so far.
    Removed the phase-0 toy (hardware/spike), gitignore covers all firmware build dirs,
    *.bak and KiCad autosaves. PLAN.md: research on alternatives to Python generators.
2026-10-15 hardware: split the skill into hw-bom, hw-schematic, hw-layout
    Each skill covers one stage with its own rules and pitfalls: part selection and the
    datasheet rule (hw-bom), readable hierarchical schematics with kicad-sch-api
    (hw-schematic), placement/routing/ground reference/fab and KiCad quirks (hw-layout).
    ORDER.md: sensor handling notes from the BME688/SHT4x datasheets.
2026-10-15 Hatched In1 GND plane under the sensor island and neck as I2C return path
    [notifier-v1.kicad_pcb]
2026-10-15 Hardware: hierarchical, reviewable schematic (root block diagram + Power, MCU, Sensors, Display)
    Real wires for coupled connections, explicit power symbols, notes and title blocks on every sheet.
    Power nets are now GND/+3V3/VBUS/VBUS_IN/SW (no leading slash); router and layout patterns updated.
    [display.kicad_sch, mcu.kicad_sch, notifier-v1.kicad_pcb, notifier-v1.kicad_sch, power.kicad_sch, sensors.kicad_sch]
2026-10-15 notifier-v1: USB 22 ohm series resistors, 1 uF at module 3V3, second buck output cap
    [display.kicad_sch, mcu.kicad_sch, notifier-v1.kicad_pcb, notifier-v1.kicad_sch, power.kicad_sch, sensors.kicad_sch]
2026-10-15 notifier-v1: 90 ohm USB pair, hand-drawn and locked
    USB D+/D- are 0.27 mm with a 0.15 mm gap on F.Cu over the In1 GND plane: 90 ohm
    differential on JLC04161H-7628 (prepreg 0.2104 mm, er 4.4, 1 oz, solder mask).
    The router left the pair partial (interleaved USB-C pads) and snaked it over
    B.Cu with ~8 vias; drawing it in layout_v1.py makes it straight, via-free and
    the pipeline passed 4 of 4 runs (was ~1 of 3).
    - U2 (USBLC6) rotated 270 for flow-through; VBUS_IN/GND middle pins by via
    - module-side nets renamed MCU_USB_DP/MCU_USB_DN (KRT pairs by suffix)
    - route_krt.sh: diff stage dropped, --keep-input-copper
    - ORDER.md: calculator inputs to verify; hw-layout skill updated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
    [display.kicad_sch, mcu.kicad_sch, notifier-v1.kicad_pcb, power.kicad_sch, sensors.kicad_sch]
2026-10-15 hardware: save schematics in the KiCad 10 format; skill lessons
    build_v1.sh runs `kicad-cli sch upgrade --force` on every sheet (the
    generator writes the 9.0 header; KiCad 10.0.7 warned on open). Skills: file
    format and diff-pair naming (hw-schematic), hand-drawn locked nets and pair
    checks (hw-layout), impedance calculator workflow (hw-bom).
    [display.kicad_sch, mcu.kicad_sch, notifier-v1.kicad_pcb, notifier-v1.kicad_sch, power.kicad_sch, sensors.kicad_sch]
2026-10-15 hardware: plan for native KiCad 10 files and the KiCad 11 transition
2026-10-15 hardware: KiCad 10 schematic tool survey in PLAN.md
2026-10-16 Sensor neck: no plane under island/neck, guarded 0.15 mm bus, wider slot
    - In1 GND left out under the sensor island and neck; the neck bus is
    3V3 | GND | SDA | SCL | GND at 0.15 mm, guards joined on B.Cu and
    stitched to In1 below the neck
    - Module-side slot widened to 1.8 mm (island side stays 1.2 mm)
    - Island hand-routed and locked (deterministic, clear of SHT40 keepout)
    - C12 4.7u bulk cap where 3V3 enters the island
    - R13 33R in series with LCD_SCLK (new net MCU_LCD_SCLK), GND vias
    beside the SPI layer changes where there is room
    - In2 island removal drops slivers between the module thermal vias
    [display.kicad_sch, mcu.kicad_sch, notifier-v1.kicad_pcb, notifier-v1.kicad_sch, power.kicad_sch, sensors.kicad_sch]
2026-10-16 Layout A: USB-C on the back edge, corner mounts, no buttons, JLC fab data
    - J2 display socket mirrored (1 RST 2 CS 3 DC 4 SDA 5 SCL 6 GND 7 VCC),
    face at the right edge
    - USB-C J1 on the left edge (enclosure back), ESD/CC/fuse beside it,
    hand-drawn 0.27/0.15 pair (~91 ohm diff, tools/impedance.py), only
    GND under the shell (DRC rule area)
    - SW1-SW3/R6/BTN removed; 1.5 mm debug pads TX RX 3V3 EN GND IO0;
    firmware DESK_BTN = -1 on notifier-v1
    - Four M2 corner holes with keepouts; sensor island grown to 14.8 mm
    with H3 in its corner, re-hand-routed (BME688/SHT40 8.9 mm apart)
    - I2C >= 1.6 mm from USB on the same layer; vias >= 0.15 mm from
    same-net SMD pads (rule), hand vias >= 0.2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
    [display.kicad_sch, mcu.kicad_sch, notifier-v1.kicad_pcb, notifier-v1.kicad_sch, power.kicad_sch, sensors.kicad_sch]
2026-10-17 Squirrel coins and the shop
    Coins: one a day from the first visit; from five hearts three a day, +10
    every 7th day in a row, +5 on special days, 20 for a golden acorn, 2 for a
    good-air day, and now and then one found in the grass. Never taken away.
    Saved with the friendship (NVS format b2, b1 still loads).
    The shop (screen/core/shop, 31 items) offers six things a day, mixed by
    the date: hats, places for the air page, things for the room, friends for
    the hill, and seasonal specials that are only sold and worn in their
    season (pumpkin hat now, Tracht hat, Christmas jumper, party glasses,
    bunny ears, swim ring). Buying unwraps the item on the air page and the
    squirrel shows it off for the rest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
2026-10-22 notifier-v1: STEP export, source for the housing
    [notifier-v1.step]
2026-10-22 Housing: Fusion model, STL/3MF exports, display dummy, fit coupon
    [coupon_m1.stl, cover.stl, desk_notifier_housing.f3d, display_dummy.stl, plate_shell_cover.3mf, plate_shell_cover.stl, shell.stl]
2026-10-22 CLAUDE.md: point to the housing
2026-10-22 README: one overview for firmware, board and case, with limitations; drop a home path from the housing plan
2026-10-22 Keep personal data out of the repo: blank birthday defaults, device notes in CLAUDE.local.md, privacy check
2026-10-28 hardware: board-neutral skills, board profile, calc check scripts
    - Skills hw-base (read first), kicad-schematic, kicad-layout, hw-parts replace
    hw-bom/hw-layout/hw-schematic. No board facts in skills; shared vocabulary in hw-base.
    - notifier-v1 profile: BOARD.md (decisions, layout specifics, pitfalls), board.yaml
    (stackup, net classes, alternates, regulator inputs), critical.yaml (critical blocks
    by intent), parts/ datasheet cards.
    - hardware/calc: pcb.py (.kicad_pcb reader without pcbnew), critical.py (switcher loop,
    feedback, decoupling, series termination, diff pair skew/vias, thermal distance),
    buck.py (Vout, ripple, Isat, Cout), impedance.py (moved from tools, reads the profi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
    [board.yaml, checks.py, critical.yaml]
2026-10-28 hardware skills: apply review (neutral wording, checks match code)
    - Skills: no board flags/paths, vocabulary covers every term used, each rule names
    its check or (review), placement order puts keepouts and thermal distance first,
    duplicates removed, descriptions sharpened.
    - board.yaml: layer roles (signal/plane), Default vias, layout settings, sourced
    derating and Isat margin; diff_pair gets its layer for the impedance solve.
    - buck.py: WARN on values without a datasheet section or source; Isat margin from
    the profile; formula source named. Gate with --bom runs it --strict.
    - checks.py: physical_clearance (custom DRC rules) can no longer be waived.
    - BOARD.md: commands (calc list,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
    [board.yaml, checks.py, critical.yaml]
2026-10-31 Sensor: take temperature and humidity from the SHT40, BME688 only for pressure and gas
    The BME688's own temperature and humidity are skewed by its gas heater
    (about 1.5 C high on the notifier-v1 board). The SHT40 (0x44) is read before
    each heater pulse; if it is missing or a read fails (CRC), the BME688 values
    are used as before. Frame decoding lives in sensor/core/sht4x with host
    tests; /api/sensor reports temp_src.
    Also drop two unused constants in props_calendar.cpp that broke the -Werror
    host build.
    [airq.hpp, bme688.cpp, props_calendar.cpp, sht4x.cpp, sht4x.hpp, web.cpp]
2026-10-31 Render and sensor: cheaper fills, gas every 10.8 s, SHT40 every 30 s
    - fill_px writes 32-bit pairs; fill() uses it for solid interiors and Canvas::rect
    clips per row; floor_i/ceil_i replace the libm calls. Output is byte-identical
    over all preview scenes.
    - BME688 gas measurement every 10.8 s (BSEC low-power rate, about 5 % heater
    duty), SHT40 temperature and humidity every 30 s, held at least 2 s clear of
    the heater pulse. Tracker warm-up and baseline decay rescaled to the new rate.
    - Reading carries the BME688's own temperature for comparison.
    [airq.cpp, airq.hpp, bme688.cpp, day_view.cpp, draw.hpp, view.cpp]
2026-10-31 Bluetooth setup, S3 as the only target, 3 MB OTA slots
    - ble component (NimBLE): status, config and Wi-Fi scan characteristics behind
    a passkey drawn on the display (screen/core/pair_view); phone page in setup/.
    - ESP32-S3 (notifier-v1) is the default target, the C61 breadboard is dropped;
    PSRAM at 80 MHz, Wi-Fi modem sleep.
    - Partition table: 2 x 3 MB OTA slots, 1.8 MB storage.
    - Console `bench` and render/blit timings in /api/status; /api/sensor shows the
    BME688's own temperature.
    [partitions.csv]
2026-10-31 Display: double-buffered frames sent from PSRAM, screen task on core 1
    - display::present() hands a whole frame to the SPI DMA in one async
    draw_bitmap (psram_dma_direct, 4 transactions of 60 lines) and returns once
    it is queued; the screen task draws the next frame into a second PSRAM buffer
    meanwhile. The time spent in the blit drops from about 30 ms to about 2 ms.
    - config allows 80 MHz SPI on the S3 IOMUX pins (default stays 40 MHz);
    /api/status reports the real SPI clock.
    - Screen task pinned to core 1 (Wi-Fi and BLE stay on core 0).
2026-10-31 Display: SPI at 80 MHz by default on the S3 board
    The panel shows no glitches at 80 MHz on the IOMUX pins (SCLK 12, MOSI 11,
    CS 10). Set in sdkconfig.defaults.esp32s3; other targets keep 40 MHz.
